JoaoVictorGordo/high-speed-robot/monografia/LaTeX/Tabelas/table.tex

\begin{table}[H]
\centering
\caption{Tabela Verdade}
\label{IA}
\begin{tabular}{|ccccc|c|}
\hline
 \textbf{Sensor 0} & \textbf{Sensor 1} & \textbf{Sensor 2} & 
 \textbf{Sensor 3} & \textbf{Sensor 4} & \textbf{Ação} \\ 
\hline
 0 & 0 & 0 & 0 & 0 & $FS$ \\ \hline
 0 & 0 & 0 & 0 & 1 & $E_L$ \\ \hline
 0 & 0 & 0 & 1 & 0 & $E_M$ \\ \hline
 0 & 0 & 0 & 1 & 1 & $E_M$ \\ \hline
 0 & 0 & 1 & 0 & 0 & $E_F$ \\ \hline
 0 & 0 & 1 & 0 & 1 & $E_F$ \\ \hline
 0 & 0 & 1 & 1 & 0 & $E_F$ \\ \hline
 0 & 0 & 1 & 1 & 1 & $E_F$ \\ \hline
 0 & 1 & 0 & 0 & 0 & $D_M$ \\ \hline
 0 & 1 & 0 & 0 & 1 & $D_M$ \\ \hline
 0 & 1 & 0 & 1 & 0 & $E_F$ \\ \hline
 0 & 1 & 0 & 1 & 1 & $E_M$ \\ \hline
 0 & 1 & 1 & 0 & 0 & $D_F$ \\ \hline
 0 & 1 & 1 & 0 & 1 & $E_F$ \\ \hline
 0 & 1 & 1 & 1 & 0 & $E_F$ \\ \hline
 0 & 1 & 1 & 1 & 1 & $E_F$ \\ \hline
 1 & 0 & 0 & 0 & 0 & $D_L$ \\ \hline
 1 & 0 & 0 & 0 & 1 & $Fre$ \\ \hline
 1 & 0 & 0 & 1 & 0 & $E_M$ \\ \hline
 1 & 0 & 0 & 1 & 1 & $E_M$ \\ \hline
 1 & 0 & 1 & 0 & 0 & $D_F$ \\ \hline
 1 & 0 & 1 & 0 & 1 & $E_F$ \\ \hline
 1 & 0 & 1 & 1 & 0 & $E_F$ \\ \hline
 1 & 0 & 1 & 1 & 1 & $E_F$ \\ \hline
 1 & 1 & 0 & 0 & 0 & $D_M$ \\ \hline
 1 & 1 & 0 & 0 & 1 & $D_M$ \\ \hline
 1 & 1 & 0 & 1 & 0 & $D_M$ \\ \hline
 1 & 1 & 0 & 1 & 1 & $Fre$ \\ \hline
 1 & 1 & 1 & 0 & 0 & $D_F$ \\ \hline
 1 & 1 & 1 & 0 & 1 & $D_F$ \\ \hline
 1 & 1 & 1 & 1 & 0 & $D_F$ \\ \hline
 1 & 1 & 1 & 1 & 1 & $E_F$ \\ \hline
\end{tabular} 
\end{table}
