JoaoVictorGordo/high-speed-robot/monografia/LaTeX/Tabelas/vazio.tex

% Please add the following required packages to your document preamble:
% \usepackage{multirow}
\begin{table}[H]
\centering
\caption{Teste sem Obstáculos ao Alcance}
\label{vazio}
\begin{tabular}{|c|c|c|ccccc|}\hline
Dados & Contagem & Intervalo & Sensor 0 & Sensor 1 & Sensor 2 & Sensor 3 & Sensor 4 \\ \hline
\multirow{6}{*}{crus} & \multirow{3}{*}{$\neq 400$} & 30ms & 0\% & 1,22\% & 0\% & 1,48\% & 0\% \\
 &  & 45ms & 0,67\% & 0,92\% & 0\% & 1,58\% & 0\% \\
 &  & 60ms & 3,17\% & 0,58\% & 0\% & 2,67\% & 0\% \\ \cline{2-8} 
 & \multirow{3}{*}{\textless \hspace{0,5mm} 10} & 30ms & 0\% & 0\% & 0\% & 0,78\% & 0\% \\
 &  & 45ms & 0,67\% & 0\% & 0\% & 0,83\% & 0\% \\
 &  & 60ms & 3,17\% & 0\% & 0\% & 1,08\% & 0\% \\ \hline
\multirow{6}{*}{processados} & \multirow{3}{*}{$\neq 400$} & 30ms & 0\% & 0,70\% & 0\% & 0,35\% & 0\% \\
 &  & 45ms & 0\% & 0,25\% & 0\% & 0,33\% & 0\% \\
 &  & 60ms & 0\% & 0,08\% & 0\% & 1,09\% & 0\% \\ \cline{2-8} 
 & \multirow{3}{*}{\textless \hspace{0,5mm} 10} & 30ms & 0\% & 0\% & 0\% & 0\% & 0\% \\
 &  & 45ms & 0\% & 0\% & 0\% & 0\% & 0\% \\
 &  & 60ms & 0\% & 0\% & 0\% & 0\% & 0\% \\ \hline
\end{tabular}
\end{table}
