JoaoVictorGordo/high-speed-robot/monografia/LaTeX/Template/folhadeaprovacao.tex

% Alternativa para a Folha de Aprovação 
% Se esta for a sua opção, exclua inclusão feita acima do arquivo folhadeaprovacao.pdf
%
\begin{folhadeaprovacao}
  \begin{center}
       {\ABNTEXchapterfont\bfseries\large\imprimirautor}
	 \vspace*{2cm}
   
    \begin{center}
      \ABNTEXchapterfont\bfseries\Large\imprimirtitulo
    \end{center}
		\vspace*{2cm}
		\hspace{.45\textwidth}
    \begin{minipage}{.5\textwidth}
        \imprimirpreambulo
    \end{minipage}
		\vspace*{2cm}
    %\vspace*{\fill}
	\end{center}

  \begin{center}
	  {\ABNTEXchapterfont\bfseries\large\ {Trabalho de Conclus\~ao de Curso defendido e aprovado\\
	  em 22 de junho de 2017}, pela Comiss\~ao Julgadora: \\}
		\par
		\vspace*{2cm}
		{\ABNTEXchapterfont\bfseries\large Prof. Dr.  Eduardo do Valle Sim\~oes - Orientador - SSC/ICMC/USP \\}
		\vspace*{1cm}
		{\ABNTEXchapterfont\bfseries\large Prof. Dr.  Marcelo Bas\'ilio Joaquim - SEL/EESC/USP\\}
		\vspace*{1cm}
		{\ABNTEXchapterfont\bfseries\large Prof. Dr.  Cl\'audio Fabiano Motta Toledo - SSC/ICMC/USP \\}
		\vspace*{1cm}
		%\assinatura{\textbf{Professor} \\ Convidado3}
		%\assinatura{\textbf{Professor} \\ Convidado4}
		%\begin{center}
		\vspace*{\fill}
   	{\ABNTEXchapterfont\bfseries\large Coordenador da CoC-Engenharia El\'etrica - EESC/USP: \\}
   	{\ABNTEXchapterfont\bfseries\large Prof. Associado Jos\'e Carlos de Melo Vieira J\'unior}
    \par
\end{center}
\end{folhadeaprovacao}
% ---
