JoaoVictorGordo/high-speed-robot/monografia/LaTeX/Tabelas/30.tex

% Please add the following required packages to your document preamble:
% \usepackage{multirow}
\begin{center}
\begin{longtable}{|c|c|c|ccccc|}
\label{30cm} \\
\caption[30cm]{30cm} \endfirsthead \\
\caption[]{30cm} \\
\hline \multicolumn{3}{|c|}{{Continua na próxima página.}} \\ \hline
\endfoot \hline
\hline \hline
\endlastfoot
\hline
\textbf{Medida} & \textbf{Intervalo} & \textbf{Leitura} & \textbf{Sensor 0} & \textbf{Sensor 1} & \textbf{Sensor 2} & \textbf{Sensor 3} & \textbf{Sensor 4} \\ \hline
\multirow{12}{*}{\begin{tabular}[c]{@{}c@{}}Média\\ {[}cm{]}\end{tabular}} & \multirow{4}{*}{30ms} & Est. & 26,43 & 30,13 & 31,14 & 35,62 & 37,19 \\
 &  & Din. & 26,58 & 30,57 & 30,55 & 35,67 & 37,51 \\
 &  & Est. & 26,37 & 30,12 & 30,99 & 35,66 & 37,21 \\
 &  & Din. & 26,42 & 30,60 & 32,17 & 35,61 & 37,52 \\ \cline{2-8} 
 & \multirow{4}{*}{45ms} & Est. & 26,36 & 30,51 & 32,61 & 35,67 & 37,34 \\
 &  & Din. & 26,39 & 30,86 & 32,31 & 35,76 & 37,73 \\
 &  & Est. & 26,45 & 30,26 & 31,59 & 35,75 & 37,17 \\
 &  & Din. & 26,42 & 30,29 & 29,11 & 35,65 & 37,36 \\ \cline{2-8} 
 & \multirow{4}{*}{60ms} & Est. & 26,41 & 30,12 & 31,28 & 35,67 & 37,21 \\
 &  & Din. & 26,72 & 30,48 & 31,11 & 35,71 & 37,65 \\
 &  & Est. & 26,46 & 30,01 & 30,38 & 35,61 & 37,15 \\
 &  & Din. & 26,52 & 30,35 & 28,47 & 35,50 & 37,33 \\ \hline
\multirow{12}{*}{\begin{tabular}[c]{@{}c@{}}Média\\ Limpa\\ {[}cm{]}\end{tabular}} & \multirow{4}{*}{30ms} & Est. & 26,43 & 30,13 & 31,14 & 35,62 & 37,19 \\
 &  & Din. & 26,58 & 30,57 & 31,16 & 35,67 & 37,51 \\
 &  & Est. & 26,37 & 30,12 & 30,99 & 35,66 & 37,21 \\
 &  & Din. & 26,42 & 30,60 & 32,69 & 35,61 & 37,52 \\ \cline{2-8} 
 & \multirow{4}{*}{45ms} & Est. & 26,36 & 30,51 & 32,61 & 35,67 & 37,34 \\
 &  & Din. & 26,39 & 30,86 & 32,82 & 35,76 & 37,73 \\
 &  & Est. & 26,45 & 30,26 & 31,59 & 35,75 & 37,17 \\
 &  & Din. & 26,42 & 30,29 & 31,91 & 35,65 & 37,36 \\ \cline{2-8} 
 & \multirow{4}{*}{60ms} & Est. & 26,41 & 30,12 & 31,28 & 35,67 & 37,21 \\
 &  & Din. & 26,72 & 30,48 & 31,59 & 35,71 & 37,65 \\
 &  & Est. & 26,46 & 30,01 & 30,38 & 35,61 & 37,15 \\
 &  & Din. & 26,52 & 30,35 & 30,84 & 35,50 & 37,33 \\ \hline \pagebreak
\multirow{12}{*}{\begin{tabular}[c]{@{}c@{}}Desvio\\ Padrão\\ {[}cm{]}\end{tabular}} & \multirow{4}{*}{30ms} & Est. & 0,50 & 0,34 & 1,51 & 0,49 & 0,41 \\
 &  & Din. & 0,50 & 0,50 & 4,19 & 0,55 & 0,53 \\
 &  & Est. & 0,48 & 0,33 & 1,19 & 0,48 & 0,43 \\
 &  & Din. & 0,50 & 0,49 & 4,35 & 0,59 & 0,55 \\ \cline{2-8} 
 & \multirow{4}{*}{45ms} & Est. & 0,48 & 0,50 & 1,68 & 0,47 & 0,52 \\
 &  & Din. & 0,49 & 0,35 & 4,12 & 0,54 & 0,62 \\
 &  & Est. & 0,50 & 0,44 & 1,63 & 0,44 & 0,41 \\
 &  & Din. & 0,50 & 0,46 & 8,18 & 0,48 & 0,63 \\ \cline{2-8} 
 & \multirow{4}{*}{60ms} & Est. & 0,49 & 0,33 & 1,42 & 0,47 & 0,41 \\
 &  & Din. & 0,45 & 0,50 & 4,10 & 0,50 & 0,69 \\
 &  & Est. & 0,50 & 0,12 & 0,70 & 0,49 & 0,38 \\
 &  & Din. & 0,50 & 0,48 & 7,47 & 0,50 & 0,49 \\ \hline
\multirow{12}{*}{\textless avg - 15} & \multirow{4}{*}{30ms} & Est. & 0,00\% & 0\% & 0\% & 0\% & 0\% \\
 &  & Din. & 0\% & 0\% & 2,67\% & 0\% & 0\% \\
 &  & Est. & 0\% & 0\% & 0\% & 0\% & 0\% \\
 &  & Din. & 0\% & 0\% & 2,00\% & 0\% & 0\% \\ \cline{2-8} 
 & \multirow{4}{*}{45ms} & Est. & 0\% & 0\% & 0\% & 0\% & 0\% \\
 &  & Din. & 0\% & 0\% & 2,00\% & 0\% & 0\% \\
 &  & Est. & 0\% & 0\% & 0\% & 0\% & 0\% \\
 &  & Din. & 0\% & 0\% & 11,33\% & 0\% & 0\% \\ \cline{2-8} 
 & \multirow{4}{*}{60ms} & Est. & 0\% & 0\% & 0\% & 0\% & 0\% \\
 &  & Din. & 0\% & 0\% & 2,00\% & 0\% & 0\% \\
 &  & Est. & 0\% & 0\% & 0\% & 0\% & 0\% \\
 &  & Din. & 0\% & 0\% & 10,00\% & 0\% & 0\% \\ \hline
\multirow{12}{*}{\textgreater avg + 15} & \multirow{4}{*}{30ms} & Est. & 0\% & 0\% & 1,33\% & 0\% & 0\% \\
 &  & Din. & 0\% & 0\% & 4,00\% & 0\% & 0\% \\
 &  & Est. & 0\% & 0\% & 0,67\% & 0\% & 0\% \\
 &  & Din. & 0\% & 0\% & 4,67\% & 0\% & 0\% \\ \cline{2-8} 
 & \multirow{4}{*}{45ms} & Est. & 0\% & 0\% & 0\% & 0\% & 0\% \\
 &  & Din. & 0\% & 0\% & 1,33\% & 0\% & 0\% \\
 &  & Est. & 0\% & 0\% & 0\% & 0\% & 0\% \\
 &  & Din. & 0\% & 0\% & 6,67\% & 0\% & 0\% \\ \cline{2-8} 
 & \multirow{4}{*}{60ms} & Est. & 0\% & 0\% & 0\% & 0\% & 0\% \\
 &  & Din. & 0\% & 0\% & 7,33\% & 0\% & 0\% \\
 &  & Est. & 0\% & 0\% & 0\% & 0\% & 0\% \\
 &  & Din. & 0\% & 0\% & 6,67\% & 0\% & 0\% \\ \hline
\multirow{12}{*}{= 400} & \multirow{4}{*}{30ms} & Est. & 0\% & 0\% & 0\% & 0\% & 0\% \\
 &  & Din. & 0\% & 0\% & 0\% & 0\% & 0\% \\
 &  & Est. & 0\% & 0\% & 0\% & 0\% & 0\% \\
 &  & Din. & 0\% & 0\% & 0\% & 0\% & 0\% \\ \cline{2-8} 
 & \multirow{4}{*}{45ms} & Est. & 0\% & 0\% & 0\% & 0\% & 0\% \\
 &  & Din. & 0\% & 0\% & 0\% & 0\% & 0\% \\
 &  & Est. & 0\% & 0\% & 0\% & 0\% & 0\% \\
 &  & Din. & 0\% & 0\% & 0\% & 0\% & 0\% \\ \cline{2-8} 
 & \multirow{4}{*}{60ms} & Est. & 0\% & 0\% & 0\% & 0\% & 0\% \\
 &  & Din. & 0\% & 0\% & 0\% & 0\% & 0\% \\
 &  & Est. & 0\% & 0\% & 0\% & 0\% & 0\% \\
 &  & Din. & 0\% & 0\% & 0\% & 0\% & 0\% \\ \hline
\end{longtable}
\end{center}
