JoaoVictorGordo/high-speed-robot/monografia/LaTeX/Tabelas/50.tex

% Please add the following required packages to your document preamble:
% \usepackage{multirow}
\begin{center}
\begin{longtable}{|c|c|c|ccccc|}
\label{50cm} \\
\caption[50cm]{50cm} \endfirsthead \\
\caption[]{50cm} \\
\hline \multicolumn{3}{|c|}{{Continua na próxima página.}} \\ \hline
\endfoot \hline
\hline \hline
\endlastfoot
\hline
\textbf{Medida} & \textbf{Intervalo} & \textbf{Leitura} & \textbf{Sensor 0} & \textbf{Sensor 1} & \textbf{Sensor 2} & \textbf{Sensor 3} & \textbf{Sensor 4} \\ \hline
\multirow{12}{*}{\begin{tabular}[c]{@{}c@{}}Média\\ {[}cm{]}\end{tabular}} & \multirow{4}{*}{30ms} & Est. & 44,80 & 47,77 & 50,86 & 48,39 & 53,25 \\
 &  & Din. & 44,57 & 47,87 & 50,13 & 48,59 & 53,65 \\
 &  & Est. & 45,21 & 47,91 & 50,86 & 48,35 & 52,49 \\
 &  & Din. & 44,95 & 47,83 & 50,65 & 48,77 & 52,65 \\ \cline{2-8} 
 & \multirow{4}{*}{45ms} & Est. & 45,35 & 47,46 & 50,45 & 48,53 & 53,61 \\
 &  & Din. & 44,85 & 47,85 & 52,61 & 48,92 & 63,21 \\
 &  & Est. & 44,70 & 47,72 & 51,35 & 48,56 & 53,06 \\
 &  & Din. & 44,79 & 47,91 & 50,87 & 48,67 & 60,42 \\ \cline{2-8} 
 & \multirow{4}{*}{60ms} & Est. & 45,86 & 47,76 & 50,81 & 48,49 & 51,69 \\
 &  & Din. & 45,27 & 47,85 & 50,74 & 48,94 & 52,55 \\
 &  & Est. & 45,68 & 47,89 & 51,54 & 48,61 & 53,26 \\
 &  & Din. & 44,78 & 47,63 & 51,29 & 48,73 & 51,33 \\ \hline  
\multirow{12}{*}{\begin{tabular}[c]{@{}c@{}}Média\\ Limpa\\ {[}cm{]}\end{tabular}} & \multirow{4}{*}{30ms} & Est. & 44,80 & 47,77 & 50,86 & 48,39 & 53,25 \\
 &  & Din. & 44,57 & 47,87 & 50,13 & 48,59 & 53,65 \\
 &  & Est. & 45,21 & 47,91 & 50,86 & 48,35 & 52,49 \\
 &  & Din. & 44,95 & 47,83 & 50,65 & 48,77 & 52,65 \\ \cline{2-8} 
 & \multirow{4}{*}{45ms} & Est. & 45,35 & 47,46 & 50,45 & 48,53 & 53,61 \\
 &  & Din. & 44,85 & 47,85 & 52,61 & 48,92 & 63,21 \\
 &  & Est. & 44,70 & 47,72 & 51,35 & 48,56 & 53,06 \\
 &  & Din. & 44,79 & 47,91 & 50,87 & 48,67 & 60,42 \\ \cline{2-8} 
 & \multirow{4}{*}{60ms} & Est. & 45,86 & 47,76 & 50,81 & 48,49 & 51,69 \\
 &  & Din. & 45,27 & 47,85 & 50,74 & 48,94 & 52,55 \\
 &  & Est. & 45,68 & 47,89 & 51,54 & 48,61 & 53,26 \\
 &  & Din. & 44,78 & 47,63 & 51,29 & 48,73 & 51,33 \\ \hline
\multirow{12}{*}{\begin{tabular}[c]{@{}c@{}}Desvio\\ Padrão\\ {[}cm{]}\end{tabular}} & \multirow{4}{*}{30ms} & Est. & 0,65 & 0,42 & 0,74 & 0,50 & 11,99 \\
 &  & Din. & 0,56 & 0,33 & 1,48 & 0,53 & 12,93 \\
 &  & Est. & 2,96 & 0,29 & 0,74 & 0,48 & 11,24 \\
 &  & Din. & 1,00 & 0,37 & 1,17 & 0,49 & 11,11 \\ \cline{2-8} 
 & \multirow{4}{*}{45ms} & Est. & 3,38 & 0,50 & 0,97 & 0,51 & 13,46 \\
 &  & Din. & 0,63 & 0,36 & 1,16 & 0,54 & 28,66 \\
 &  & Est. & 0,76 & 0,45 & 0,81 & 0,50 & 12,03 \\
 &  & Din. & 0,53 & 0,28 & 0,70 & 0,51 & 26,26 \\ \cline{2-8} 
 & \multirow{4}{*}{60ms} & Est. & 7,40 & 0,43 & 0,87 & 0,50 & 7,44 \\
 &  & Din. & 2,98 & 0,35 & 0,81 & 0,48 & 8,89 \\
 &  & Est. & 6,25 & 0,31 & 0,81 & 0,50 & 11,92 \\
 &  & Din. & 0,53 & 0,48 & 1,30 & 0,49 & 5,41 \\ \hline
\multirow{12}{*}{\textless avg - 15} & \multirow{4}{*}{30ms} & Est. &0\% &0\% &0\% &0\% &0\% \\
 &  & Din. &0\% &0\% &0\% &0\% &0\% \\
 &  & Est. &0\% &0\% &0\% &0\% &0\% \\
 &  & Din. &0\% &0\% &0\% &0\% &0\% \\ \cline{2-8} 
 & \multirow{4}{*}{45ms} & Est. &0\% &0\% &0\% &0\% &0\% \\
 &  & Din. &0\% &0\% &0\% &0\% &0\% \\
 &  & Est. &0\% &0\% &0\% &0\% &0\% \\
 &  & Din. &0\% &0\% &0\% &0\% &0\% \\ \cline{2-8} 
 & \multirow{4}{*}{60ms} & Est. &0\% &0\% &0\% &0\% &0\% \\
 &  & Din. &0\% &0\% &0\% &0\% &0\% \\
 &  & Est. &0\% &0\% &0\% &0\% &0\% \\
 &  & Din. &0\% &0\% &0\% &0\% &0\% \\ \hline
\multirow{12}{*}{\textgreater avg + 15} & \multirow{4}{*}{30ms} & Est. &0\% &0\% &0\% &0\% & 4,00\% \\
 &  & Din. &0\% &0\% &0\% &0\% & 5,33\% \\
 &  & Est. & 0,67\% &0\% &0\% &0\% & 2,67\% \\
 &  & Din. &0\% &0\% &0\% &0\% & 2,67\% \\ \cline{2-8} 
 & \multirow{4}{*}{45ms} & Est. & 0,67\% &0\% &0\% &0\% & 4,00\% \\
 &  & Din. &0\% &0\% &0\% &0\% & 16,00\% \\
 &  & Est. &0\% &0\% &0\% &0\% & 3,33\% \\
 &  & Din. &0\% &0\% &0\% &0\% & 12,67\% \\ \cline{2-8} 
 & \multirow{4}{*}{60ms} & Est. & 1,33\% &0\% &0\% &0\% & 1,33\% \\
 &  & Din. & 0,67\% &0\% &0\% &0\% & 2,67\% \\
 &  & Est. & 1,33\% &0\% &0\% &0\% & 4,67\% \\
 &  & Din. &0\% &0\% &0\% &0\% & 0,67\% \\ \hline
\multirow{12}{*}{= 400} & \multirow{4}{*}{30ms} & Est. &0\% &0\% &0\% &0\% &0\% \\
 &  & Din. &0\% &0\% &0\% &0\% &0\% \\
 &  & Est. &0\% &0\% &0\% &0\% &0\% \\
 &  & Din. &0\% &0\% &0\% &0\% &0\% \\ \cline{2-8} 
 & \multirow{4}{*}{45ms} & Est. &0\% &0\% &0\% &0\% &0\% \\
 &  & Din. &0\% &0\% &0\% &0\% &0\% \\
 &  & Est. &0\% &0\% &0\% &0\% &0\% \\
 &  & Din. &0\% &0\% &0\% &0\% &0\% \\ \cline{2-8} 
 & \multirow{4}{*}{60ms} & Est. &0\% &0\% &0\% &0\% &0\% \\
 &  & Din. &0\% &0\% &0\% &0\% &0\% \\
 &  & Est. &0\% &0\% &0\% &0\% &0\% \\
 &  & Din. &0\% &0\% &0\% &0\% &0\% \\ \hline
\end{longtable}
\end{center}
