JoaoVictorGordo/high-speed-robot/monografia/LaTeX/Tabelas/interf-motor-sonar_1.tex

% Please add the following required packages to your document preamble:
% \usepackage{multirow}
\begin{table}[]
\centering
\caption{Teste 1}
\label{teste_1}
\begin{tabular}{|c|c|ccccc|}
\hline
\textbf{Motores}                & \textbf{Medida}  & \textbf{Sensor 0} & \textbf{Sensor 1} & \textbf{Sensor 2} & \textbf{Sensor 3} & \textbf{Sensor 4} \\ \hline
\multirow{3}{*}{STP}            & Média            & 399               & 339               & 400               & 400               & 400               \\
                                & \textless 400    & 0,43\%            & 21,26\%           & 0\%            & 0\%            & 0\%            \\
                                & \textgreater 400 & 0\%            & 0\%            & 0\%            & 0\%            & 0\%            \\ \hline
\multirow{3}{*}{E\_L}           & Média            & 399               & 236               & 400               & 400               & 400               \\
                                & \textless 400    & 0,30\%            & 59,34\%           & 0\%            & 0\%            & 0\%            \\
                                & \textgreater 400 & 0\%            & 0\%            & 0\%            & 0\%            & 0\%            \\ \hline
\multirow{3}{*}{E\_M}           & Média            & 400               & 219               & 400               & 400               & 400               \\
                                & \textless 400    & 0\%            & 66,56\%           & 0\%            & 0\%            & 0\%            \\
                                & \textgreater 400 & 0\%            & 0\%            & 0\%            & 0\%            & 0\%            \\ \hline
\multirow{3}{*}{E\_F}           & Média            & 400               & 233               & 400               & 400               & 400               \\
                                & \textless 400    & 0\%            & 61,28\%           & 0\%            & 0\%            & 0\%            \\
                                & \textgreater 400 & 0\%            & 0\%            & 0\%            & 0\%            & 0\%            \\ \hline
\multirow{3}{*}{D\_L}           & Média            & 399               & 316               & 400               & 400               & 400               \\
                                & \textless 400    & 0,34\%            & 31,54\%           & 0\%            & 0\%            & 0\%            \\
                                & \textgreater 400 & 0\%            & 0\%            & 0\%            & 0\%            & 0\%            \\ \hline
\multirow{3}{*}{D\_M}           & Média            & 400               & 217               & 400               & 400               & 400               \\
                                & \textless 400    & 0\%            & 66,78\%           & 0\%            & 0\%            & 0\%            \\
                                & \textgreater 400 & 0\%            & 0\%            & 0\%            & 0\%            & 0\%            \\ \hline
\multirow{3}{*}{D\_F}           & Média            & 400               & 247               & 400               & 400               & 400               \\
                                & \textless 400    & 0\%            & 55,56\%           & 0\%            & 0\%            & 0\%            \\
                                & \textgreater 400 & 0\%            & 0\%            & 0\%            & 0\%            & 0\%            \\ \hline
\multirow{3}{*}{FS}             & Média            & 400               & 290               & 400               & 400               & 400               \\
                                & \textless 400    & 0\%            & 40,27\%           & 0\%            & 0\%            & 0\%            \\
                                & \textgreater 400 & 0\%            & 0\%            & 0\%            & 0\%            & 0\%            \\ \hline
\multirow{3}{*}{Fre}            & Média            & 400               & 156               & 400               & 400               & 400               \\
                                & \textless 400    & 0\%            & 89,23\%           & 0\%            & 0\%            & 0\%            \\
                                & \textgreater 400 & 0\%            & 0\%            & 0\%            & 0\%            & 0\%            \\ \hline
\multirow{4}{*}{\textbf{TOTAL}} & Média            & 399               & 261               & 400               & 400               & 400               \\
                                & Desvio Padrão    & 13                & 138               & 0                 & 0                 & 0                 \\
                                & \textless 400    & 0,16\%            & 50,42\%           & 0\%            & 0\%            & 0\%            \\
                                & \textgreater 400 & 0\%            & 0\%            & 0\%            & 0\%            & 0\%            \\ \hline
\end{tabular}
\end{table}
