JoaoVictorGordo/high-speed-robot/monografia/LaTeX/Tabelas/interf-motor-sonar_2.tex

% Please add the following required packages to your document preamble:
% \usepackage{multirow}
\begin{table}[H]
\centering
\caption{Teste com os Sonares Apoiados no Chão}
\label{teste_2}
\begin{tabular}{|c|c|ccccc|}
\hline
\textbf{Motores}                & \textbf{Medida}  & \textbf{Sensor 0} & \textbf{Sensor 1} & \textbf{Sensor 2} & \textbf{Sensor 3} & \textbf{Sensor 4} \\ \hline
\multirow{3}{*}{STP}            & Média            & 400               & 373               & 400               & 400               & 400               \\
                                & \textless 400    & 0\%            & 11,09\%           & 0\%            & 0\%            & 0\%            \\
                                & \textgreater 400 & 0\%            & 0\%            & 0\%            & 0\%            & 0\%            \\ \hline
\multirow{3}{*}{E\_L}           & Média            & 400               & 141               & 400               & 400               & 400               \\
                                & \textless 400    & 0\%            & 89,55\%           & 0\%            & 0\%            & 0\%            \\
                                & \textgreater 400 & 0\%            & 0\%            & 0\%            & 0\%            & 0\%            \\ \hline
\multirow{3}{*}{E\_M}           & Média            & 400               & 121               & 400               & 400               & 400               \\
                                & \textless 400    & 0\%            & 96,97\%           & 0\%            & 0\%            & 0\%            \\
                                & \textgreater 400 & 0\%            & 0\%            & 0\%            & 0\%            & 0\%            \\ \hline
\multirow{3}{*}{E\_F}           & Média            & 400               & 116               & 400               & 400               & 400               \\
                                & \textless 400    & 0\%            & 98,48\%           & 0\%            & 0\%            & 0\%            \\
                                & \textgreater 400 & 0\%            & 0\%            & 0\%            & 0\%            & 0\%            \\ \hline
\multirow{3}{*}{D\_L}           & Média            & 400               & 207               & 400               & 400               & 400               \\
                                & \textless 400    & 0\%            & 67,84\%           & 0\%            & 0\%            & 0\%            \\
                                & \textgreater 400 & 0\%            & 0\%            & 0\%            & 0\%            & 0\%            \\ \hline
\multirow{3}{*}{D\_M}           & Média            & 400               & 148               & 400               & 400               & 400               \\
                                & \textless 400    & 0\%            & 87,94\%           & 0\%            & 0\%            & 0\%            \\
                                & \textgreater 400 & 0\%            & 0\%            & 0\%            & 0\%            & 0\%            \\ \hline
\multirow{3}{*}{D\_F}           & Média            & 400               & 242               & 400               & 400               & 400               \\
                                & \textless 400    & 0\%            & 56,57\%           & 0\%            & 0\%            & 0\%            \\
                                & \textgreater 400 & 0\%            & 0\%            & 0\%            & 0\%            & 0\%            \\ \hline
\multirow{3}{*}{FS}             & Média            & 400               & 218               & 400               & 400               & 400               \\
                                & \textless 400    & 0\%            & 64,65\%           & 0\%            & 0\%            & 0\%            \\
                                & \textgreater 400 & 0\%            & 0\%            & 0\%            & 0\%            & 0\%            \\ \hline
\multirow{3}{*}{Fre}            & Média            & 400               & 123               & 400               & 400               & 400               \\
                                & \textless 400    & 0\%            & 96,48\%           & 0\%            & 0\%            & 0\%            \\
                                & \textgreater 400 & 0\%            & 0\%            & 0\%            & 0\%            & 0\%            \\ \hline
\multirow{4}{*}{\textbf{TOTAL}} & Média            & 400               & 210               & 400               & 400               & 400               \\
                                & Desvio Padrão    & 0                 & 135               & 0                 & 0                 & 0                 \\
                                & \textless 400    & 0\%            & 66,83\%           & 0\%            & 0\%            & 0\%            \\
                                & \textgreater 400 & 0\%            & 0\%            & 0\%            & 0\%            & 0\%            \\ \hline
\end{tabular}
\end{table}
