JoaoVictorGordo/high-speed-robot/monografia/LaTeX/Tabelas/interf-motor-sonar_4.tex

% Please add the following required packages to your document preamble:
% \usepackage{multirow}
\begin{table}[H]
\centering
\caption{Teste com os Sonares Acoplados ao Veículo}
\label{teste_4}
\begin{tabular}{|c|c|ccccc|}
\hline
\textbf{Motores}                & \textbf{Medida}  & \textbf{Sensor 0} & \textbf{Sensor 1} & \textbf{Sensor 2} & \textbf{Sensor 3} & \textbf{Sensor 4} \\ \hline
\multirow{3}{*}{STP}            & Média            & 400               & 400               & 400               & 398               & 400               \\
                                & \textless 400    & 0,23\%            & 0\%            & 0\%            & 0,70\%            & 0\%            \\
                                & \textgreater 400 & 0\%            & 0\%            & 0\%            & 0\%            & 0\%            \\ \hline
\multirow{3}{*}{E\_L}           & Média            & 163               & 222               & 400               & 90                & 232               \\
                                & \textless 400    & 91,58\%           & 66,34\%           & 0\%            & 98,51\%           & 71,29\%           \\
                                & \textgreater 400 & 3,47\%            & 0\%            & 0\%            & 0\%            & 4,46\%            \\ \hline
\multirow{3}{*}{E\_M}           & Média            & 143               & 196               & 400               & 90                & 209               \\
                                & \textless 400    & 98,48\%           & 77,78\%           & 0\%            & 100\%          & 83,33\%           \\
                                & \textgreater 400 & 1,01\%            & 0\%            & 0\%            & 0\%            & 4,55\%            \\ \hline
\multirow{3}{*}{E\_F}           & Média            & 176               & 198               & 400               & 91                & 250               \\
                                & \textless 400    & 93,43\%           & 77,27\%           & 0\%            & 100\%          & 61,62\%           \\
                                & \textgreater 400 & 2,02\%            & 0\%            & 0\%            & 0\%            & 2,53\%            \\ \hline
\multirow{3}{*}{D\_L}           & Média            & 174               & 229               & 400               & 84                & 238               \\
                                & \textless 400    & 89,95\%           & 62,81\%           & 0\%            & 100\%          & 66,33\%           \\
                                & \textgreater 400 & 2,51\%            & 0\%            & 0\%            & 0\%            & 4,02\%            \\ \hline
\multirow{3}{*}{D\_M}           & Média            & 180               & 332               & 400               & 99                & 369               \\
                                & \textless 400    & 94,95\%           & 27,27\%           & 0\%            & 100\%          & 21,21\%           \\
                                & \textgreater 400 & 1,52\%            & 0\%            & 0\%            & 0\%            & 3,03\%            \\ \hline
\multirow{3}{*}{D\_F}           & Média            & 292               & 386               & 400               & 132               & 380               \\
                                & \textless 400    & 50,25\%           & 6,03\%            & 0\%            & 99,50\%           & 14,57\%           \\
                                & \textgreater 400 & 5,53\%            & 0\%            & 0\%            & 0,50\%            & 2,01\%            \\ \hline
\multirow{3}{*}{FS}             & Média            & 192               & 232               & 400               & 90                & 253               \\
                                & \textless 400    & 77,89\%           & 60,80\%           & 0\%            & 99,50\%           & 57,29\%           \\
                                & \textgreater 400 & 0,50\%            & 0\%            & 0\%            & 0,50\%            & 0,50\%            \\ \hline
\multirow{3}{*}{Fre}            & Média            & 181               & 252               & 400               & 86                & 274               \\
                                & \textless 400    & 81,82\%           & 53,03\%           & 0\%            & 100\%          & 56,06\%           \\
                                & \textgreater 400 & 2,02\%            & 0\%            & 0\%            & 0\%            & 2,53\%            \\ \hline
\multirow{4}{*}{\textbf{TOTAL}} & Média            & 233               & 287               & 400               & 160               & 302               \\
                                & Desvio Padrão    & 132               & 134               & 0                 & 128               & 128               \\
                                & \textless 400    & 66,80\%           & 42,45\%           & 0\%            & 78,62\%           & 42,50\%           \\
                                & \textgreater 400 & 1,83\%            & 0\%            & 0\%            & 0,10\%            & 2,33\%            \\ \hline
\end{tabular}
\end{table}
