JoaoVictorGordo/high-speed-robot/monografia/LaTeX/Tabelas/interf-motor-sonar_5.tex

% Please add the following required packages to your document preamble:
% \usepackage{multirow}
\begin{table}[]
\centering
\caption{Teste 5}
\label{teste_5}
\begin{tabular}{|c|c|ccccc|}
\hline
\textbf{Motores}                & \textbf{Medida}  & \textbf{Sensor 0} & \textbf{Sensor 1} & \textbf{Sensor 2} & \textbf{Sensor 3} & \textbf{Sensor 4} \\ \hline
\multirow{3}{*}{STP}            & Média            & 399               & 399               & 400               & 398               & 399               \\
                                & \textless 400    & 0,37\%            & 0,37\%            & 0\%            & 0,75\%            & 0,37\%            \\
                                & \textgreater 400 & 0\%            & 0\%            & 0\%            & 0\%            & 0\%            \\ \hline
\multirow{3}{*}{E\_L}           & Média            & 205               & 276               & 400               & 154               & 383               \\
                                & \textless 400    & 84,85\%           & 45,96\%           & 0\%            & 95,45\%           & 10,10\%           \\
                                & \textgreater 400 & 8,08\%            & 0\%            & 0\%            & 2,53\%            & 3,54\%            \\ \hline
\multirow{3}{*}{E\_M}           & Média            & 148               & 326               & 400               & 220               & 331               \\
                                & \textless 400    & 99,49\%           & 27,78\%           & 0\%            & 73,23\%           & 32,32\%           \\
                                & \textgreater 400 & 0,51\%            & 0\%            & 0\%            & 1,52\%            & 3,54\%            \\ \hline
\multirow{3}{*}{E\_F}           & Média            & 204               & 363               & 400               & 247               & 365               \\
                                & \textless 400    & 83,33\%           & 14,65\%           & 0\%            & 56,06\%           & 21,21\%           \\
                                & \textgreater 400 & 3,54\%            & 0\%            & 0\%            & 3,03\%            & 4,04\%            \\ \hline
\multirow{3}{*}{D\_L}           & Média            & 203               & 293               & 400               & 179               & 367               \\
                                & \textless 400    & 83,42\%           & 41,21\%           & 0\%            & 81,41\%           & 14,57\%           \\
                                & \textgreater 400 & 5,03\%            & 0\%            & 0\%            & 2,51\%            & 0,50\%            \\ \hline
\multirow{3}{*}{D\_M}           & Média            & 210               & 397               & 400               & 285               & 400               \\
                                & \textless 400    & 88,24\%           & 0,98\%            & 0\%            & 63,73\%           & 0\%            \\
                                & \textgreater 400 & 2,94\%            & 0\%            & 0\%            & 6,86\%            & 0\%            \\ \hline
\multirow{3}{*}{D\_F}           & Média            & 316               & 400               & 400               & 400               & 400               \\
                                & \textless 400    & 47,47\%           & 0\%            & 0\%            & 0\%            & 0\%            \\
                                & \textgreater 400 & 6,06\%            & 0\%            & 0\%            & 0\%            & 0\%            \\ \hline
\multirow{3}{*}{FS}             & Média            & 247               & 325               & 400               & 211               & 355               \\
                                & \textless 400    & 63,64\%           & 30,30\%           & 0\%            & 73,74\%           & 17,17\%           \\
                                & \textgreater 400 & 2,02\%            & 0\%            & 0\%            & 4,04\%            & 0\%            \\ \hline
\multirow{3}{*}{Fre}            & Média            & 200               & 306               & 400               & 186               & 395               \\
                                & \textless 400    & 83,84\%           & 33,33\%           & 0\%            & 84,85\%           & 2,02\%            \\
                                & \textgreater 400 & 4,04\%            & 1,01\%            & 0\%            & 6,06\%            & 2,02\%            \\ \hline
\multirow{4}{*}{\textbf{TOTAL}} & Média            & 243               & 342               & 400               & 255               & 376               \\
                                & Desvio Padrão    & 128               & 111               & 0                 & 139               & 75                \\
                                & \textless 400    & 67,17\%           & 22,07\%           & 0\%            & 56,96\%           & 11,99\%           \\
                                & \textgreater 400 & 3,36\%            & 0,07\%            & 0\%            & 2,47\%            & 1,71\%            \\ \hline
\end{tabular}
\end{table}
