JoaoVictorGordo/high-speed-robot/monografia/LaTeX/Template/USPSC-Dedicatoria.tex

%% USPSC-Dedicatória.tex
% ---
% Dedicatória
% ---
\begin{dedicatoria}
   \vspace*{\fill}
   \centering
   \noindent
   \textit{ Este trabalho é dedicado aos alunos da USP, como uma contribuição\\
  das Bibliotecas do Campus USP de São Carlos para o desenvolvimento\\
	e disseminação da pesquisa científica da Universidade.} \vspace*{\fill}
\end{dedicatoria}
% ---
