JoaoVictorGordo/high-speed-robot/monografia/LaTeX/Template/USPSC-modelo-seg.tex

%% USPSC-modelo.tex
% ---------------------------------------------------------------
% USPSC: Modelo de Trabalho Academico (tese de doutorado, dissertacao de
% mestrado e trabalhos monograficos em geral) em conformidade com 
% ABNT NBR 14724:2011: Informacao e documentacao - Trabalhos academicos -
% Apresentacao
%----------------------------------------------------------------
%% Esta é uma customização do abntex2-modelo-trabalho-academico.tex de v-1.9.5 laurocesar 
%% para as Unidades do Campus USP de São Carlos:
%% EESC - Escola de Engenharia de São Carlos
%% IAU - Instituto de Arquitetura e Urbanismo
%% ICMC - Instituto de Ciências Matemáticas e de Computação
%% IFSC - Instituto de Física de São Carlos
%% IQSC - Instituto de Química de São Carlos
%%
%% Este trabalho utiliza a classe USPSC.cls que é mantida pela seguinte equipe:
%% 
%% Programação:
%%   - Marilza Aparecida Rodrigues Tognetti - marilza@sc.usp.br (PUSP-SC)
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

% Complementarmente, verifique as instruções abaixo sobre os Pacotes de Nota de rodapé
% ---
% Pacotes de Nota de rodapé
% Configurações de nota de rodapé

% O presente modelo adota o formato numérico para as notas de rodapés quando utiliza o sistema de chamada autor-data para citações e referências. Para utilizar o sistema de chamada numérico para citações e referências, habilitar um dos comandos abaixo.
% Há diversa opções para nota de rodapé no Sistema Numérico.  Para o IFSC, habilitade o comando abaixo.

%\renewcommand{\thefootnote}{\fnsymbol{footnote}}  %Comando para inserção de símbolos em nota de rodapé

% Outras opções para nota de rodapé no Sistema Numérico:
%\renewcommand{\thefootnote}{\alph{footnote}}      %Comando para inserção de letras minúscula em nota de rodapé
%\renewcommand{\thefootnote}{\Alph{footnote}}      %Comando para inserção de letras maiúscula em nota de rodapé
%\renewcommand{\thefootnote}{\roman{footnote}}     %Comando para inserção de números romanos minúsculos  em nota de rodapé
%\renewcommand{\thefootnote}{\Roman{footnote}}     %Comando para inserção de números romanos minúsculos  em nota de rodapé

\renewcommand{\footnotesize}{\small} %Comando para diminuir a fonte das notas de rodapé

 % ---
 % Pacote para agrupar a citação numérica consecutiva
 % Quando for adotado o Sistema Numérico, a exemplo do IFSC, habilite 
 % o pacote cite abaixo retirando a porcentagem antes do comando abaixo
 %\usepackage[superscript]{cite}	

% ---
% Pacotes adicionais, usados apenas no âmbito do Modelo Canônico do abnteX2
% ---
\usepackage{lipsum}				% para geração de dummy text
% ---

% pacotes de tabelas
\usepackage{multicol}	% Suporte a mesclagens em colunas
\usepackage{multirow}	% Suporte a mesclagens em linhas
\usepackage{longtable}	% Tabelas com várias páginas
\usepackage{threeparttablex}    % notas no longtable
\usepackage{array}

%---
% Configurações para o pacote chemfig
%\chemsetup[chemformula]{format=\sffamily}
\renewcommand*\printatom[1]{\ensuremath{\mathsf{#1}}}
\setatomsep{2em}
\setdoublesep{.6ex}
\setbondstyle{semithick}
%---
% Configurando o ambiente para utilizar os recursos de frases pre-prontas do mhchem
\newenvironment{rslist}%
{%
	\begin{labeling}% environment from KOMA-script
		{\rsnumber{R39/23/24/25}}% R39/23/24/25 is longest label
	}{%
\end{labeling}%
}%
% Definição de comando para utilizar os recursos de frases pre-prontas do mhchem
\newcommand{\rs}[2][]{\item[{\rsnumber[#1]{#2}}] \rsphrase{bb}}
% ---

% ---
% DADOS INICIAIS - Define sigla com título, área de concentração e opção do Programa 
% Consulte a tabela referente aos Programas, áreas e opções de sua unidade contante do
% arquivo USPSC-Siglas estabelecidas para os Programas de Pós-Graduação por Unidade.xlsx 
% ou nos APÊNDICES A-E
\siglaunidade{EESC}
\programa{DCEA}
% Os demais dados deverão ser fornecidos no arquivo USPSC-pre-textual-UUUU, onde UUUU é a sigla da Unidade. 
% Exemplo:USPSC-pre-textual-IFSC.tex
% ---
% Configurações de aparência do PDF final
% alterando o aspecto da cor azul
\definecolor{blue}{RGB}{41,5,195}

% informações do PDF
\makeatletter
\hypersetup{
	%pagebackref=true,
	pdftitle={\@title}, 
	pdfauthor={\@author},
	pdfsubject={\imprimirpreambulo},
	pdfcreator={LaTeX with abnTeX2},
	pdfkeywords={abnt}{latex}{abntex}{USPSC}{trabalho acadêmico}, 
	colorlinks=true,       		% false: boxed links; true: colored links
	linkcolor=blue,          	% color of internal links
	citecolor=blue,        		% color of links to bibliography
	filecolor=magenta,      		% color of file links
	urlcolor=blue,
	bookmarksdepth=4
}
\makeatother
% --- 
% --- 
% Espaçamentos entre linhas e parágrafos 
% --- 

% O tamanho do parágrafo é dado por:
\setlength{\parindent}{1.3cm}

% Controle do espaçamento entre um parágrafo e outro:
\setlength{\parskip}{0.2cm}  % tente também \onelineskip

% ---
% compila o sumário e índice
\makeindex
% ---

% ----
% Início do documento
% ----
\begin{document}

% Seleciona o idioma do documento (conforme pacotes do babel)
\selectlanguage{brazil}
% Se o idioma do texto for inglês, inclua uma % antes do 
%      comando \selectlanguage{brazil} e 
%      retire a % antes do comando abaixo
%\selectlanguage{english}

% Retira espaço extra obsoleto entre as frases.
\frenchspacing 

% --- Formatação dos Títulos
\renewcommand{\ABNTEXchapterfontsize}{\fontsize{12}{12}\bfseries}
\renewcommand{\ABNTEXsectionfontsize}{\fontsize{12}{12}\bfseries}
\renewcommand{\ABNTEXsubsectionfontsize}{\fontsize{12}{12}\normalfont}
\renewcommand{\ABNTEXsubsubsectionfontsize}{\fontsize{12}{12}\normalfont}
\renewcommand{\ABNTEXsubsubsubsectionfontsize}{\fontsize{12}{12}\normalfont}

% ----------------------------------------------------------
% ELEMENTOS PRÉ-TEXTUAIS
% ----------------------------------------------------------
% ---
% Capa
% ---
\imprimircapa
% ---
% Folha de rosto
% (o * indica impressão em anverso (frente) e verso )
% ---
\imprimirfolhaderosto*
%\imprimirfolhaderosto
% ---

% ---
% Inserir a ficha catalográfica em pdf
% ---
% A biblioteca da sua Unidade lhe fornecerá um PDF com a ficha
% catalográfica definitiva. 
% Quando estiver com o documento, salve-o como PDF no diretório
% do seu projeto como fichacatalografica.pdf e iclua o arquivo
% utilizando o comando abaixo:
\begin{fichacatalografica}
   \includepdf{fichacatalografica.pdf}
\end{fichacatalografica}
% Se você optar por elaborar a ficha catalográfica, deverá 
% incluir uma % antes das 3 linhas acima e tirar a % antes
% do comando \include{USPSC-fichacatalografica}
%\include{USPSC-fichacatalografica}
% As informações que compõem a ficha catalográfica estão 
% definidos no arquivo USPSC-pre-textual-UUUU.tex
% ---

% ---
% Inserir errata
% ---

\begin{errata}
	\OnehalfSpacing 			
	A errata é um elemento opcional, que consiste de uma lista de erros da obra, precedidos pelas folhas e linhas onde eles ocorrem e seguidos pelas correções correspondentes. Deve ser inserida logo após a folha de rosto e conter a referência do trabalho para facilitar sua identificação, conforme a ABNT NBR 14724 \cite{nbr14724}.
	
	Modelo de Errata:
		
	\begin{flushleft} 
			\setlength{\absparsep}{0pt} % ajusta o espaçamento da referência	
			\SingleSpacing 
			\imprimirautorabr~ ~\textbf{\imprimirtitulo}.	\imprimirdata. \pageref{LastPage}p. 
			%Substitua p. por f. quando utilizar oneside em \documentclass
			%\pageref{LastPage}f.
			\imprimirtipotrabalho~-~\imprimirinstituicao, \imprimirlocal, \imprimirdata. 
 	\end{flushleft}
\vspace{\onelineskip}
\OnehalfSpacing 
\center
\textbf{ERRATA}
\vspace{\onelineskip}
\OnehalfSpacing 
\begin{table}[htb]
	\center
	\footnotesize
	\begin{tabular}{p{1.4cm} p{1cm} p{3cm} p{3cm} }
		\hline
		\textbf{Folha} & \textbf{Linha}  & \textbf{Onde se lê}  & \textbf{Leia-se}  \\
			\hline
			1 & 10 & auto-conclavo & autoconclavo\\
		\hline
	\end{tabular}
\end{table}

\end{errata}
% ---

% ---
% Inserir folha de aprovação
% ---

% A Folha de aprovação é um elemento obrigatório da NBR 4724/2011 (seção 4.2.1.3). 
% Após a defesa/aprovação do trabalho, gere o arquivo folhadeaprovacao.pdf da página assinada pela banca 
% e iclua o arquivo utilizando o comando abaixo:
\includepdf{folhadeaprovacao.pdf}

% Alternativa para a Folha de Aprovação:
% Se for a sua opção elaborar uma folha de aprovação, insira uma % antes do comando acima que inclui o arquivo folhadeaprovacao.pdf,
% tire o % do comando abaixo e altere o arquivo folhadeaprovacao.tex conforme suas necessidades
%\include{folhadeaprovacao}

\includepdf{PaginaEmBranco.pdf}

% ---
% Dedicatória
% ---
\begin{dedicatoria}
   \vspace*{\fill}
   \centering
   \noindent
   \textit{ Este trabalho é dedicado aos alunos da USP, como uma contribuição\\
  das Bibliotecas do Campus USP de São Carlos para o desenvolvimento\\
	e disseminação da pesquisa científica da Universidade.} \vspace*{\fill}
\end{dedicatoria}
% ---

% ---
% Agradecimentos
% ---=====
\begin{agradecimentos}
A motivação para o desenvolvimento da classe USPSC e dos modelos de dissertações e teses foi decorrente de solicitações de usuários das Bibliotecas do Campus USP de São Carlos. 

O Grupo desenvolvedor do Pacote USPSC, atualmente composto da Classe USPSC e do  Modelo para teses e dissertações em \LaTeX\ utilizando a classe USPSC, agradece especialmente ao Luis Olmes, doutorando do Instituto de Ciências Matemáticas e de Computação (ICMC) da Universidade de São Paulo (USP), pelas primeiras orientações sobre o \LaTeX\ .

Agradecemos ao Lauro César Araujo pelo desenvolvimento da classe  \abnTeX, modelos canônicos e tantas outras contribuições que nos permitiu o desenvolvimento da classe USPSC e seus modelos.

Os nossos agradecimentos aos integrantes do primeiro
projeto abn\TeX\, Gerald Weber, Miguel Frasson, Leslie H. Watter, Bruno Parente Lima, Flávio de Vasconcellos Corrêa, Otavio Real
Salvador, Renato Machnievscz, e a todos que contribuíram para que a produção de trabalhos acadêmicos em conformidade com
as normas ABNT com \LaTeX\ fosse possível.

Agradecemos ao grupo de usuários
\emph{latex-br}{\url{http://groups.google.com/group/latex-br}}, aos integrantes do grupo
\emph{\abnTeX}{\url{http://groups.google.com/group/abntex2}  e \url{http://www.abntex.net.br/}}~que contribuem para a evolução do \abnTeX.
\end{agradecimentos}
% ---

% ---
% Epígrafe
% ---
\begin{epigrafe}
    \vspace*{\fill}
	\begin{flushright}
		\textit{``O estudo, a busca da verdade e da beleza são domínios \\
		em que nos é consentido sermos crianças por toda a vida.''\\
		Albert Einstein}
	\end{flushright}
\end{epigrafe}
% ---

% ---
% Resumo
% ---
% Se o idioma do texto for em inglês, o abstract deve preceder o resumo
% resumo em português
\setlength{\absparsep}{18pt} % ajusta o espaçamento dos parágrafos do resumo		
\begin{resumo}
	\begin{flushleft} 
			\setlength{\absparsep}{0pt} % ajusta o espaçamento da referência	
			\SingleSpacing 
			\imprimirautorabr~ ~\textbf{\imprimirtitulo}.	\imprimirdata. \pageref{LastPage}p. 
			%Substitua p. por f. quando utilizar oneside em \documentclass
			%\pageref{LastPage}f.
			\imprimirtipotrabalho~-~\imprimirinstituicao, \imprimirlocal, \imprimirdata. 
 	\end{flushleft}
\OnehalfSpacing 			
 O resumo deve ressaltar o  objetivo, o método, os resultados e as conclusões do documento. A ordem e a extensão  destes itens dependem do tipo de resumo (informativo ou indicativo) e do  tratamento que cada item recebe no documento original. O resumo deve ser
 precedido da referência do documento, com exceção do resumo inserido no
 próprio documento. (\ldots)  Salientamos que os Programas de Pós-Graduação de algumas Unidades exigem o titulo da dissertação ou tese em inglês, tornando necessário a inclusão das referências nos resumos e abstracts, o que foi adotado no presente modelo. As palavras-chave devem figurar logo abaixo do  resumo, antecedidas da expressão Palavras-chave:, separadas entre si por  ponto e finalizadas também por ponto \cite{nbr6028}.

 \textbf{Palavras-chave}: LaTeX. abnTeX. Classe USPSC. Editoração de texto. Normalização da documentação. Tese. Dissertação. Documentos (elaboração). Documentos eletrônicos. 
\end{resumo}

% ---
% Abstract
% ---
\autor{Silva, M. J.}
\begin{resumo}[Abstract]
 \begin{otherlanguage*}{english}
	\begin{flushleft} 
		\setlength{\absparsep}{0pt} % ajusta o espaçamento dos parágrafos do resumo		
 		\SingleSpacing 
 		\imprimirautorabr~ ~\textbf{\imprimirtitleabstract}.	\imprimirdata.  \pageref{LastPage}p. 
		%Substitua p. por f. quando utilizar oneside em \documentclass
		%\pageref{LastPage}f.
		\imprimirtipotrabalho~-~\imprimirinstituicao, \imprimirlocal, 	\imprimirdata. 
 	\end{flushleft}
	\OnehalfSpacing 
   This is the english abstract.

   \vspace{\onelineskip}
 
   \noindent 
   \textbf{Keywords}: LaTeX. abnTeX. USPSC class. Text editoration. Standardization of documentation. Thesis. Dissertation. Documents (development). Electronic documents.
 \end{otherlanguage*}
\end{resumo}

% ---
% inserir lista de ilustrações
% ---
\pdfbookmark[0]{\listfigurename}{lof}
\listoffigures*
\cleardoublepage
% ---

% ---
% inserir lista de tabelas
% ---
\pdfbookmark[0]{\listtablename}{lot}
\listoftables*
\cleardoublepage
% ---

% ---
% inserir lista de quadros
% ---
\pdfbookmark[0]{\listofquadroname}{loq}
\listofquadro*
\cleardoublepage
% ---

% ---
% inserir lista de abreviaturas e siglas
% ---
\begin{siglas}
    \item[ABNT] Associação Brasileira de Normas Técnicas
    \item[abnTeX] ABsurdas Normas para TeX
	\item[EESC] Escola de Engenharia de São Carlos
	\item[IAU] Instituto de Arquitetura e Urbanismo
	\item[IBGE] Instituto Brasileiro de Geografia e Estatística
	\item[ICMC] Instituto de Ciências Matemáticas e de Computação
	\item[IFSC] Instituto de Física de São Carlos
	\item[IQSC] Instituto de Química de São Carlos
	\item[USP] Universidade de São Paulo
	\item[USPSC] Campus USP de São Carlos
	
\end{siglas}
% ---

% ---
% inserir lista de símbolos
% ---
\begin{simbolos}
  \item[$ \Gamma $] Letra grega Gama
  \item[$ \Lambda $] Lambda
  \item[$ \zeta $] Letra grega minúscula zeta
  \item[$ \in $] Pertence
\end{simbolos}
% ---
% ---
% inserir o sumario
% ---
\pdfbookmark[0]{\contentsname}{toc}
\tableofcontents*
\cleardoublepage
% ---
% ----------------------------------------------------------
% ELEMENTOS TEXTUAIS
% ----------------------------------------------------------
\textual
% Os capítulos são inseridos como arquivos externos 

% Capítulo 1 - Introdução
% ---
\include{USPSC-Cap1-Introducao}
% ---

% ---
% Capítulo 2
% ---
\include{USPSC-Cap2-Desenvolvimento}
% ---
% Capítulo 3 - Citações
% ---
\include{USPSC-Cap3-Citacoes}

% ---
% Capítulo 4 - Referencias
% ---
\include{USPSC-Cap4-Referencias}
% ---

% Capítulo 5 - Conclusão
% ---
\include{USPSC-Cap5-Conclusao}
% ---

% ----------------------------------------------------------
% ELEMENTOS PÓS-TEXTUAIS
% ----------------------------------------------------------
\postextual
% ----------------------------------------------------------

% -----------------------------------------------------------
% Referências bibliográficas
% ----------------------------------------------------------
\bibliography{USPSC-modelo-references}

% ----------------------------------------------------------
% Glossário
% ----------------------------------------------------------
%
% Consulte o manual da classe abntex2 para orientações sobre o glossário.
%
%\glossary

% ----------------------------------------------------------
% Apêndices
% ----------------------------------------------------------
\include{USPSC-Apendices}

% ----------------------------------------------------------
% Anexos
% ----------------------------------------------------------
\include{USPSC-Anexos}

%---------------------------------------------------------------------
% INDICE REMISSIVO
%--------------------------------------------------------------------
\phantompart
\printindex

%---------------------------------------------------------------------

\end{document}
