JoaoVictorGordo/high-speed-robot/monografia/LaTeX/Template/USPSC-TCC-modelo.tex

% %% USPSC-TCC-modelo.tex
% ---------------------------------------------------------------
% USPSC: Modelo de Trabalho Academico (tese de doutorado, dissertacao de
% mestrado e trabalhos monograficos em geral) em conformidade com 
% ABNT NBR 14724:2011: Informacao e documentacao - Trabalhos academicos -
% Apresentacao
%----------------------------------------------------------------
%% Esta é uma customização do abntex2-modelo-trabalho-academico.tex de v-1.9.5 laurocesar 
%% para as Unidades do Campus USP de São Carlos:
%% EESC - Escola de Engenharia de São Carlos
%% IAU - Instituto de Arquitetura e Urbanismo
%% ICMC - Instituto de Ciências Matemáticas e de Computação
%% IFSC - Instituto de Física de São Carlos
%% IQSC - Instituto de Química de São Carlos
%%
%% Este trabalho utiliza a classe USPSC.cls que é mantida pela seguinte equipe:
%% 
%% Programação:
%%   - Marilza Aparecida Rodrigues Tognetti - marilza@sc.usp.br (PUSP-SC)
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

% Complementarmente, verifique as instruções abaixo sobre os Pacotes de Nota de rodapé
% ---
% Pacotes de Nota de rodapé
% Configurações de nota de rodapé

% O presente modelo adota o formato numérico para as notas de rodapés quando utiliza o sistema de chamada autor-data para citações e referências. Para utilizar o sistema de chamada numérico para citações e referências, habilitar um dos comandos abaixo.
% Há diversa opções para nota de rodapé no Sistema Numérico.  Para o IFSC, habilitade o comando abaixo.

%\renewcommand{\thefootnote}{\fnsymbol{footnote}}  %Comando para inserção de símbolos em nota de rodapé

% Outras opções para nota de rodapé no Sistema Numérico:
%\renewcommand{\thefootnote}{\alph{footnote}}      %Comando para inserção de letras minúscula em nota de rodapé
%\renewcommand{\thefootnote}{\Alph{footnote}}      %Comando para inserção de letras maiúscula em nota de rodapé
%\renewcommand{\thefootnote}{\roman{footnote}}     %Comando para inserção de números romanos minúsculos  em nota de rodapé
%\renewcommand{\thefootnote}{\Roman{footnote}}     %Comando para inserção de números romanos minúsculos  em nota de rodapé

\renewcommand{\footnotesize}{\small} %Comando para diminuir a fonte das notas de rodapé

 % ---
 % Pacote para agrupar a citação numérica consecutiva
 % Quando for adotado o Sistema Numérico, a exemplo do IFSC, habilite 
 % o pacote cite abaixo retirando a porcentagem antes do comando abaixo

% pacotes de tabelas
\usepackage{multicol}	% Suporte a mesclagens em colunas
\usepackage{multirow}	% Suporte a mesclagens em linhas
\usepackage{longtable}	% Tabelas com várias páginas
\usepackage{threeparttablex}    % notas no longtable
\usepackage{array}

%---
% Configurações para o pacote chemfig
%\chemsetup[chemformula]{format=\sffamily}
\renewcommand*\printatom[1]{\ensuremath{\mathsf{#1}}}
\setatomsep{2em}
\setdoublesep{.6ex}
\setbondstyle{semithick}
%---
% Configurando o ambiente para utilizar os recursos de frases pre-prontas do mhchem
\newenvironment{rslist}%
{%
	\begin{labeling}% environment from KOMA-script
		{\rsnumber{R39/23/24/25}}% R39/23/24/25 is longest label
	}{%
\end{labeling}%
}%
% Definição de comando para utilizar os recursos de frases pre-prontas do mhchem
\newcommand{\rs}[2][]{\item[{\rsnumber[#1]{#2}}] \rsphrase{bb}}
% ---

% ---
% DADOS INICIAIS - Define sigla com título, área de concentração e opção do Programa 
% Consulte a tabela referente aos Cursos de Graduação de sua unidade contante do
% arquivo USPSC-TCC-Siglas estabelecidas para as Graduações por Unidade.xlsx 
% ou no APÊNDICES G
\siglaunidade{EESC-TCC} 
\programa{EELT}
% Os demais dados deverão ser fornecidos no arquivo USPSC-pre-textual-UUUU ou USPSC-TCC-pre-textual-UUUU, onde UUUU é a sigla da Unidade. 
% Exemplo:USPSC-pre-textual-IFSC.tex
% ---
% Configurações de aparência do PDF final
% alterando o aspecto da cor azul
\definecolor{blue}{RGB}{41,5,195}

% informações do PDF
\makeatletter
\hypersetup{
	%pagebackref=true,
	pdftitle={\@title}, 
	pdfauthor={\@author},
	pdfsubject={\imprimirpreambulo},
	pdfcreator={LaTeX with abnTeX2},
	pdfkeywords={navegação autônoma}{sistemas reativos}{sensores ultrassônicos}{desvio de obstáculos}, 
	colorlinks=true,       		% false: boxed links; true: colored links
	linkcolor=blue,          	% color of internal links
	citecolor=blue,        		% color of links to bibliography
	filecolor=magenta,      		% color of file links
	urlcolor=blue,
	bookmarksdepth=4
}
\makeatother
% --- 
% --- 
% Espaçamentos entre linhas e parágrafos 
% --- 

% O tamanho do parágrafo é dado por:
\setlength{\parindent}{1.3cm}

% Controle do espaçamento entre um parágrafo e outro:
\setlength{\parskip}{0.2cm}  % tente também \onelineskip

% ---
% compila o sumário e índice
\makeindex
% ---

% ----
% Início do documento
% ----
\begin{document}

% Seleciona o idioma do documento (conforme pacotes do babel)
\selectlanguage{brazil}
% Se o idioma do texto for inglês, inclua uma % antes do 
%      comando \selectlanguage{brazil} e 
%      retire a % antes do comando abaixo
%\selectlanguage{english}

% Retira espaço extra obsoleto entre as frases.
\frenchspacing 

% --- Formatação dos Títulos
\renewcommand{\ABNTEXchapterfontsize}{\fontsize{12}{12}\bfseries}
\renewcommand{\ABNTEXsectionfontsize}{\fontsize{12}{12}\bfseries}
\renewcommand{\ABNTEXsubsectionfontsize}{\fontsize{12}{12}\normalfont}
\renewcommand{\ABNTEXsubsubsectionfontsize}{\fontsize{12}{12}\normalfont}
\renewcommand{\ABNTEXsubsubsubsectionfontsize}{\fontsize{12}{12}\normalfont}

% ----------------------------------------------------------
% ELEMENTOS PRÉ-TEXTUAIS
% ----------------------------------------------------------
% ---
% Capa
% ---
\imprimircapa
% ---
% Folha de rosto
% (o * indica impressão em anverso (frente) e verso )
% ---
\imprimirfolhaderosto*

\includepdf{fichacatalografica.pdf}

%\imprimirfolhaderosto
% ---
% ---
% Inserir a ficha catalográfica em pdf
% ---
% A biblioteca da sua Unidade lhe fornecerá um PDF com a ficha
% catalográfica definitiva. 
% Quando estiver com o documento, salve-o como PDF no diretório
% do seu projeto como fichacatalografica.pdf e iclua o arquivo
% utilizando o comando abaixo:
%\includepdf{USPSC-Tese-pre-textual/fichacatalografica.pdf} 
% Se você optar por elaborar a ficha catalográfica, deverá 
% incluir uma % antes da linha % antes
% do comando \include{USPSC-Tese-pre-textual/USPSC-fichacatalografica} 
% e retirar o % do comando abaixo
%\include{USPSC-Tese-pre-textual/USPSC-fichacatalografica}
% As informações que compõem a ficha catalográfica estão 
% definidos no arquivo USPSC-pre-textual-UUUU.tex
% ---

% ---
% ---
% Inserir errata
% ---

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

% ---
% Inserir folha de aprovação
% ---

% A Folha de aprovação é um elemento obrigatório da NBR 4724/2011 (seção 4.2.1.3). 
% Após a defesa/aprovação do trabalho, gere o arquivo folhadeaprovacao.pdf da página assinada pela banca 
% e iclua o arquivo utilizando o comando abaixo:

 \includepdf{folhadeaprovacao.pdf}
 
% Alternativa para a Folha de Aprovação:
% Se for a sua opção elaborar uma folha de aprovação, insira uma % antes do comando acima que inclui o arquivo folhadeaprovacao.pdf,
% tire o % do comando abaixo e altere o arquivo folhadeaprovacao.tex conforme suas necessidades
% \include{folhadeaprovacao}

% \include{USPSC-fichacatalografica}
\includepdf{PaginaEmBranco.pdf}

% ---
% Agradecimentos
% ---
\begin{agradecimentos}
Eu gostaria de agradecer à comunidade que vive o paradigma revolucionário de disseminação livre e gratuita de ideias e trabalhos.
Este projeto é um fruto tímido de uma árvore regada pelos esforços de cada uma destas pessoas que, de gota em gota, clareiam as águas 
turvadas pelo egoísmo e nutrem a germinação de verdadeiros pomares que estão por vir. Quem sabe um dia o único obstáculo ao aprendizado e construção 
do conhecimento seja a força de vontade...
\end{agradecimentos}
% ---

% Resumo
% ---
\input{../Resumo/Resumo.tex}
% ---

% ---
% inserir lista de figurass
% ---
\pdfbookmark[0]{\listfigurename}{lof}
\listoffigures*
\cleardoublepage
% ---

% ---
% inserir lista de tabelas
% ---
\pdfbookmark[0]{\listtablename}{lot}
\listoftables*
\cleardoublepage
% ---

% ---
% inserir lista de quadros
% ---
% \pdfbookmark[0]{\listofquadroname}{loq}
% \listofquadro*
% \cleardoublepage
% ---

% ---
% inserir lista de abreviaturas e siglas
% ---
\begin{siglas}
  \item[CC] Corrente Contínua
  \item[PWM] \textit{Pulse Width Modulation}
  \item[ESC] \textit{Electronic Speed Controller}
  \item[IDE] \textit{Integrated Development Environment}
  \item[ISM] \textit{Industrial, Scientific and Medical}
  \item[UHF] \textit{Ultra High Frequency}
  \item[SPI] \textit{Serial Peripheral Interface} 
  \item[USB] \textit{Universal Serial Bus}
  \item[CRC] \textit{Cyclic Redundancy Check}
  \item[GFSK] \textit{Gaussian Frequency Shift Keying}
  \item[BLDC] \textit{Brushless Direct Current}
  \item[FIFO] \textit{First In First Out}
  \item[VANT] \textit{Veículo Aereo Não Tripulado}
  \item[UBEC] \textit{Ultimate Batterie Eliminator Circuit}
  \item[LiPo] Lítio Polímero
  \item[MIFA] \textit{Meandered Inverted-F Antenna}
  \item[ICSP] \textit{In-Circuit Serial Programming}
\end{siglas}

% ---

% ---
% inserir lista de símbolos
% ---
\begin{simbolos}
  \item[$ \alpha $] coeficiente de atenuação do meio.
  \item[$ \tau $] tempo de meia volta da onda propagante, i.e. \textit{time of flight}, do sensor.
  \item[$ \Delta $] distância medida nos sensores do tipo \textit{time of flight}.
  \item[$ \nu $] velocidade de propagação no meio da onda ou partícula nos sensores do tipo \textit{time of flight}.
\end{simbolos}
% ---
% ---
% inserir o sumario
% ---
\pdfbookmark[0]{\contentsname}{toc}
\tableofcontents*
\cleardoublepage
% ---
% ----------------------------------------------------------
% ELEMENTOS TEXTUAIS
% ----------------------------------------------------------
\textual
% Os capítulos são inseridos como arquivos externos 
\input{../Introducao/Introducao.tex}
\input{../EmbasamentoTeorico/EmbasamentoTeorico.tex}
\input{../Materiais/Materiais.tex}
\input{../Metodos/Metodos.tex}
\input{../Resultados/Resultados.tex}
\input{../Conclusao/Conclusao.tex}

% ----------------------------------------------------------
% ELEMENTOS PÓS-TEXTUAIS
% ----------------------------------------------------------
\postextual
% ----------------------------------------------------------

% -----------------------------------------------------------
% Referências bibliográficas
% ----------------------------------------------------------
\bibliography{../Bibliografia/Bibliografia.bib}

% ----------------------------------------------------------
% Glossário
% ----------------------------------------------------------
%
% Consulte o manual da classe abntex2 para orientações sobre o glossário.
%
%\glossary

% ----------------------------------------------------------
% Apêndices
% ----------------------------------------------------------
\input{../Apendices/Apendices.tex}

%---------------------------------------------------------------------
% INDICE REMISSIVO
%--------------------------------------------------------------------
\include{USPSC-IndicesRemissivos}

%---------------------------------------------------------------------

\end{document}
