JoaoVictorGordo/high-speed-robot/monografia/LaTeX/Tabelas/bkp2/100.tex

% Please add the following required packages to your document preamble:
% \usepackage{multirow}
\begin{center}
\begin{longtable}{|c|c|c|ccccc|}
\label{100cm} \\
\caption[100cm]{100cm} \endfirsthead \\
\caption[]{100cm} \\
\hline \multicolumn{3}{|c|}{{Continua na próxima página.}} \\ \hline
\endfoot \hline
\hline \hline
\endlastfoot
\hline
\textbf{Medida} & \textbf{Intervalo} & \textbf{Leitura} & \textbf{Sensor 0} & \textbf{Sensor 1} & \textbf{Sensor 2} & \textbf{Sensor 3} & \textbf{Sensor 4} \\ \hline
\multirow{12}{*}{\begin{tabular}[c]{@{}c@{}}Média\\ {[}cm{]}\end{tabular}} & \multirow{4}{*}{30ms} & Est. & 102,49 & 106,83 & 96,83 & 92,05 & 94,19 \\
 &  & Din. & 102,71 & 107,05 & 97,07 & 92,46 & 94,74 \\
 &  & Est. & 102,41 & 106,85 & 96,83 & 92,21 & 94,49 \\
 &  & Din. & 102,46 & 106,91 & 97,19 & 92,54 & 94,54 \\ \cline{2-8} 
 & \multirow{4}{*}{45ms} & Est. & 102,78 & 106,86 & 96,96 & 92,05 & 94,29 \\
 &  & Din. & 102,31 & 106,82 & 97,10 & 92,37 & 94,49 \\
 &  & Est. & 102,41 & 106,89 & 97,07 & 92,20 & 94,27 \\
 &  & Din. & 102,37 & 106,83 & 97,07 & 92,23 & 94,20 \\ \cline{2-8} 
 & \multirow{4}{*}{60ms} & Est. & 102,63 & 106,96 & 97,46 & 92,14 & 94,24 \\
 &  & Din. & 102,34 & 106,81 & 97,23 & 92,46 & 94,53 \\
 &  & Est. & 102,59 & 106,90 & 97,07 & 92,43 & 94,60 \\
 &  & Din. & 102,07 & 106,77 & 97,18 & 92,51 & 94,65 \\ \hline
\multirow{12}{*}{\begin{tabular}[c]{@{}c@{}}Média\\ Limpa\\ {[}cm{]}\end{tabular}} & \multirow{4}{*}{30ms} & Est. & 102,49 & 106,83 & 96,83 & 92,05 & 94,19 \\
 &  & Din. & 102,71 & 107,05 & 97,07 & 92,46 & 94,74 \\
 &  & Est. & 102,41 & 106,85 & 96,83 & 92,21 & 94,49 \\
 &  & Din. & 102,46 & 106,91 & 97,19 & 92,54 & 94,54 \\ \cline{2-8} 
 & \multirow{4}{*}{45ms} & Est. & 102,78 & 106,86 & 96,96 & 92,05 & 94,29 \\
 &  & Din. & 102,31 & 106,82 & 97,10 & 92,37 & 94,49 \\
 &  & Est. & 102,41 & 106,89 & 97,07 & 92,20 & 94,27 \\
 &  & Din. & 102,37 & 106,83 & 97,07 & 92,23 & 94,20 \\ \cline{2-8} 
 & \multirow{4}{*}{60ms} & Est. & 102,63 & 106,96 & 97,46 & 92,14 & 94,24 \\
 &  & Din. & 102,34 & 106,81 & 97,23 & 92,46 & 94,53 \\
 &  & Est. & 102,59 & 106,90 & 97,07 & 92,43 & 94,60 \\
 &  & Din. & 102,07 & 106,77 & 97,18 & 92,51 & 94,65 \\ \hline
\multirow{12}{*}{\begin{tabular}[c]{@{}c@{}}Desvio\\ Padrão\\ {[}cm{]}\end{tabular}} & \multirow{4}{*}{30ms} & Est. & 0,66 & 0,39 & 0,78 & 0,24 & 1,02 \\
 &  & Din. & 0,99 & 0,44 & 0,73 & 0,53 & 1,12 \\
 &  & Est. & 0,66 & 0,38 & 0,77 & 0,41 & 1,01 \\
 &  & Din. & 0,66 & 0,29 & 0,75 & 0,57 & 0,98 \\ \cline{2-8} 
 & \multirow{4}{*}{45ms} & Est. & 0,83 & 0,35 & 0,72 & 0,33 & 1,01 \\
 &  & Din. & 0,60 & 0,39 & 0,78 & 0,56 & 0,99 \\
 &  & Est. & 0,66 & 0,31 & 0,77 & 0,42 & 0,83 \\
 &  & Din. & 0,66 & 0,40 & 0,81 & 0,44 & 0,62 \\ \cline{2-8}  \pagebreak
 & \multirow{4}{*}{60ms} & Est. & 0,69 & 0,33 & 2,52 & 0,37 & 1,07 \\
 &  & Din. & 0,61 & 0,39 & 0,76 & 0,54 & 0,95 \\
 &  & Est. & 0,73 & 0,34 & 0,72 & 0,50 & 1,22 \\
 &  & Din. & 0,53 & 0,42 & 0,71 & 0,58 & 0,99 \\ \hline
\multirow{12}{*}{\textless avg - 15} & \multirow{4}{*}{30ms} & Est. & 0,00\% & 0,00\% & 0,00\% & 0,00\% & 0,00\% \\
 &  & Din. & 0,00\% & 0,00\% & 0,00\% & 0,00\% & 0,00\% \\
 &  & Est. & 0,00\% & 0,00\% & 0,00\% & 0,00\% & 0,00\% \\
 &  & Din. & 0,00\% & 0,00\% & 0,00\% & 0,00\% & 0,00\% \\ \cline{2-8} 
 & \multirow{4}{*}{45ms} & Est. & 0,00\% & 0,00\% & 0,00\% & 0,00\% & 0,00\% \\
 &  & Din. & 0,00\% & 0,00\% & 0,00\% & 0,00\% & 0,00\% \\
 &  & Est. & 0,00\% & 0,00\% & 0,00\% & 0,00\% & 0,00\% \\
 &  & Din. & 0,00\% & 0,00\% & 0,00\% & 0,00\% & 0,00\% \\ \cline{2-8} 
 & \multirow{4}{*}{60ms} & Est. & 0,00\% & 0,00\% & 0,00\% & 0,00\% & 0,00\% \\
 &  & Din. & 0,00\% & 0,00\% & 0,00\% & 0,00\% & 0,00\% \\
 &  & Est. & 0,00\% & 0,00\% & 0,00\% & 0,00\% & 0,00\% \\
 &  & Din. & 0,00\% & 0,00\% & 0,00\% & 0,00\% & 0,00\% \\ \hline
\multirow{12}{*}{\textgreater avg + 15} & \multirow{4}{*}{30ms} & Est. & 0,00\% & 0,00\% & 0,00\% & 0,00\% & 0,00\% \\
 &  & Din. & 0,00\% & 0,00\% & 0,00\% & 0,00\% & 0,00\% \\
 &  & Est. & 0,00\% & 0,00\% & 0,00\% & 0,00\% & 0,00\% \\
 &  & Din. & 0,00\% & 0,00\% & 0,00\% & 0,00\% & 0,00\% \\ \cline{2-8} 
 & \multirow{4}{*}{45ms} & Est. & 0,00\% & 0,00\% & 0,00\% & 0,00\% & 0,00\% \\
 &  & Din. & 0,00\% & 0,00\% & 0,00\% & 0,00\% & 0,00\% \\
 &  & Est. & 0,00\% & 0,00\% & 0,00\% & 0,00\% & 0,00\% \\
 &  & Din. & 0,00\% & 0,00\% & 0,00\% & 0,00\% & 0,00\% \\ \cline{2-8} 
 & \multirow{4}{*}{60ms} & Est. & 0,00\% & 0,00\% & 0,67\% & 0,00\% & 0,00\% \\
 &  & Din. & 0,00\% & 0,00\% & 0,00\% & 0,00\% & 0,00\% \\
 &  & Est. & 0,00\% & 0,00\% & 0,00\% & 0,00\% & 0,00\% \\
 &  & Din. & 0,00\% & 0,00\% & 0,00\% & 0,00\% & 0,00\% \\ \hline
\multirow{12}{*}{= 400} & \multirow{4}{*}{30ms} & Est. & 0,00\% & 0,00\% & 0,00\% & 0,00\% & 0,00\% \\
 &  & Din. & 0,00\% & 0,00\% & 0,00\% & 0,00\% & 0,00\% \\
 &  & Est. & 0,00\% & 0,00\% & 0,00\% & 0,00\% & 0,00\% \\
 &  & Din. & 0,00\% & 0,00\% & 0,00\% & 0,00\% & 0,00\% \\ \cline{2-8} 
 & \multirow{4}{*}{45ms} & Est. & 0,00\% & 0,00\% & 0,00\% & 0,00\% & 0,00\% \\
 &  & Din. & 0,00\% & 0,00\% & 0,00\% & 0,00\% & 0,00\% \\
 &  & Est. & 0,00\% & 0,00\% & 0,00\% & 0,00\% & 0,00\% \\
 &  & Din. & 0,00\% & 0,00\% & 0,00\% & 0,00\% & 0,00\% \\ \cline{2-8} 
 & \multirow{4}{*}{60ms} & Est. & 0,00\% & 0,00\% & 0,00\% & 0,00\% & 0,00\% \\
 &  & Din. & 0,00\% & 0,00\% & 0,00\% & 0,00\% & 0,00\% \\
 &  & Est. & 0,00\% & 0,00\% & 0,00\% & 0,00\% & 0,00\% \\
 &  & Din. & 0,00\% & 0,00\% & 0,00\% & 0,00\% & 0,00\% \\ \hline
\end{longtable}
\end{center}
