JoaoVictorGordo/high-speed-robot/monografia/LaTeX/Tabelas/bkp2/150.tex

% Please add the following required packages to your document preamble:
% \usepackage{multirow}
\begin{center}
\begin{longtable}{|c|c|c|ccccc|}
\label{150cm} \\
\caption[150cm]{150cm} \endfirsthead \\
\caption[]{150cm} \\
\hline \multicolumn{3}{|c|}{{Continua na próxima página.}} \\ \hline
\endfoot \hline
\hline \hline
\endlastfoot
\hline
\textbf{Medida} & \textbf{Intervalo} & \textbf{Leitura} & \textbf{Sensor 0} & \textbf{Sensor 1} & \textbf{Sensor 2} & \textbf{Sensor 3} & \textbf{Sensor 4} \\ \hline
\multirow{12}{*}{\begin{tabular}[c]{@{}c@{}}Média\\ {[}cm{]}\end{tabular}} & \multirow{4}{*}{30ms} & Est. & 148,52 & 152,17 & 152,97 & 156,65 & 230,77 \\
 &  & Din. & 148,70 & 153,18 & 153,45 & 156,41 & 174,46 \\
 &  & Est. & 148,97 & 153,53 & 153,65 & 156,53 & 196,81 \\
 &  & Din. & 149,05 & 153,01 & 153,63 & 156,95 & 176,01 \\ \cline{2-8} 
 & \multirow{4}{*}{45ms} & Est. & 149,13 & 153,13 & 153,95 & 156,42 & 184,03 \\
 &  & Din. & 148,62 & 153,01 & 153,10 & 156,97 & 226,32 \\
 &  & Est. & 148,63 & 151,45 & 153,23 & 157,11 & 210,04 \\
 &  & Din. & 148,90 & 153,04 & 154,24 & 157,13 & 192,36 \\ \cline{2-8} 
 & \multirow{4}{*}{60ms} & Est. & 148,84 & 153,09 & 153,42 & 156,79 & 256,77 \\
 &  & Din. & 148,53 & 152,96 & 153,33 & 157,28 & 161,61 \\
 &  & Est. & 148,49 & 152,95 & 153,03 & 156,81 & 164,53 \\
 &  & Din. & 148,45 & 152,57 & 152,18 & 156,33 & 229,58 \\ \hline \multirow{12}{*}{\begin{tabular}[c]{@{}c@{}}Média\\ Limpa\\ {[}cm{]}\end{tabular}} & \multirow{4}{*}{30ms} & Est. & 148,52 & 152,17 & 152,97 & 156,65 & 158,25 \\
 &  & Din. & 148,70 & 153,18 & 153,45 & 156,41 & 158,35 \\
 &  & Est. & 148,97 & 153,53 & 153,65 & 156,53 & 158,10 \\
 &  & Din. & 149,05 & 153,01 & 153,63 & 156,95 & 158,28 \\ \cline{2-8} 
 & \multirow{4}{*}{45ms} & Est. & 149,13 & 153,13 & 153,95 & 156,42 & 158,25 \\
 &  & Din. & 148,62 & 153,01 & 153,10 & 156,97 & 158,78 \\
 &  & Est. & 148,63 & 151,45 & 153,23 & 157,11 & 158,53 \\
 &  & Din. & 148,90 & 153,04 & 154,24 & 157,13 & 158,56 \\ \cline{2-8} 
 & \multirow{4}{*}{60ms} & Est. & 148,84 & 153,09 & 153,42 & 156,79 & 158,60 \\
 &  & Din. & 148,53 & 152,96 & 153,33 & 157,28 & 158,39 \\
 &  & Est. & 148,49 & 152,95 & 153,03 & 156,81 & 158,08 \\
 &  & Din. & 148,45 & 152,57 & 152,18 & 156,33 & 158,84 \\ \hline \pagebreak
\multirow{12}{*}{\begin{tabular}[c]{@{}c@{}}Desvio\\ Padrão\\ {[}cm{]}\end{tabular}} & \multirow{4}{*}{30ms} & Est. & 0,60 & 7,48 & 6,44 & 0,76 & 111,16 \\
 &  & Din. & 0,63 & 0,39 & 0,64 & 0,88 & 60,49 \\
 &  & Est. & 0,52 & 0,50 & 0,65 & 0,68 & 88,98 \\
 &  & Din. & 0,47 & 0,08 & 0,61 & 0,68 & 63,23 \\ \cline{2-8} 
 & \multirow{4}{*}{45ms} & Est. & 0,42 & 0,33 & 0,73 & 0,74 & 74,88 \\
 &  & Din. & 0,63 & 0,23 & 0,86 & 0,82 & 108,67 \\
 &  & Est. & 0,61 & 9,46 & 0,89 & 0,64 & 99,26 \\
 &  & Din. & 0,47 & 0,30 & 6,01 & 0,72 & 84,06 \\ \cline{2-8} 
 & \multirow{4}{*}{60ms} & Est. & 0,57 & 0,28 & 0,63 & 0,57 & 118,98 \\
 &  & Din. & 0,62 & 0,20 & 0,62 & 0,65 & 27,81 \\
 &  & Est. & 0,54 & 0,21 & 0,68 & 0,61 & 39,11 \\
 &  & Din. & 0,59 & 4,90 & 5,68 & 0,89 & 110,18 \\ \hline
\multirow{12}{*}{\textless avg - 15} & \multirow{4}{*}{30ms} & Est. & 0,00\% & 1,33\% & 0,67\% & 0,00\% & 0,00\% \\
 &  & Din. & 0,00\% & 0,00\% & 0,00\% & 0,00\% & 0,00\% \\
 &  & Est. & 0,00\% & 0,00\% & 0,00\% & 0,00\% & 0,00\% \\
 &  & Din. & 0,00\% & 0,00\% & 0,00\% & 0,00\% & 0,00\% \\ \cline{2-8} 
 & \multirow{4}{*}{45ms} & Est. & 0,00\% & 0,00\% & 0,00\% & 0,00\% & 0,00\% \\
 &  & Din. & 0,00\% & 0,00\% & 0,00\% & 0,00\% & 0,00\% \\
 &  & Est. & 0,00\% & 2,67\% & 0,00\% & 0,00\% & 0,00\% \\
 &  & Din. & 0,00\% & 0,00\% & 0,00\% & 0,00\% & 0,00\% \\ \cline{2-8} 
 & \multirow{4}{*}{60ms} & Est. & 0,00\% & 0,00\% & 0,00\% & 0,00\% & 0,00\% \\
 &  & Din. & 0,00\% & 0,00\% & 0,00\% & 0,00\% & 0,00\% \\
 &  & Est. & 0,00\% & 0,00\% & 0,00\% & 0,00\% & 0,00\% \\
 &  & Din. & 0,00\% & 0,67\% & 1,33\% & 0,00\% & 0,00\% \\ \hline
\multirow{12}{*}{\textgreater avg + 15} & \multirow{4}{*}{30ms} & Est. & 0,00\% & 0,00\% & 0,00\% & 0,00\% & 0,00\% \\
 &  & Din. & 0,00\% & 0,00\% & 0,00\% & 0,00\% & 0,00\% \\
 &  & Est. & 0,00\% & 0,00\% & 0,00\% & 0,00\% & 0,00\% \\
 &  & Din. & 0,00\% & 0,00\% & 0,00\% & 0,00\% & 0,00\% \\ \cline{2-8} 
 & \multirow{4}{*}{45ms} & Est. & 0,00\% & 0,00\% & 0,00\% & 0,00\% & 0,00\% \\
 &  & Din. & 0,00\% & 0,00\% & 0,00\% & 0,00\% & 0,00\% \\
 &  & Est. & 0,00\% & 0,00\% & 0,00\% & 0,00\% & 0,00\% \\
 &  & Din. & 0,00\% & 0,00\% & 0,67\% & 0,00\% & 0,00\% \\ \cline{2-8} 
 & \multirow{4}{*}{60ms} & Est. & 0,00\% & 0,00\% & 0,00\% & 0,00\% & 0,00\% \\
 &  & Din. & 0,00\% & 0,00\% & 0,00\% & 0,00\% & 0,00\% \\
 &  & Est. & 0,00\% & 0,00\% & 0,00\% & 0,00\% & 0,00\% \\
 &  & Din. & 0,00\% & 0,00\% & 0,00\% & 0,00\% & 0,00\% \\ \hline
\multirow{12}{*}{= 400} & \multirow{4}{*}{30ms} & Est. & 0,00\% & 0,00\% & 0,00\% & 0,00\% & 30,00\% \\
 &  & Din. & 0,00\% & 0,00\% & 0,00\% & 0,00\% & 6,67\% \\
 &  & Est. & 0,00\% & 0,00\% & 0,00\% & 0,00\% & 16,00\% \\
 &  & Din. & 0,00\% & 0,00\% & 0,00\% & 0,00\% & 7,33\% \\ \cline{2-8} 
 & \multirow{4}{*}{45ms} & Est. & 0,00\% & 0,00\% & 0,00\% & 0,00\% & 10,67\% \\
 &  & Din. & 0,00\% & 0,00\% & 0,00\% & 0,00\% & 28,00\% \\
 &  & Est. & 0,00\% & 0,00\% & 0,00\% & 0,00\% & 21,33\% \\
 &  & Din. & 0,00\% & 0,00\% & 0,00\% & 0,00\% & 14,00\% \\ \cline{2-8} 
 & \multirow{4}{*}{60ms} & Est. & 0,00\% & 0,00\% & 0,00\% & 0,00\% & 40,67\% \\
 &  & Din. & 0,00\% & 0,00\% & 0,00\% & 0,00\% & 1,33\% \\
 &  & Est. & 0,00\% & 0,00\% & 0,00\% & 0,00\% & 2,67\% \\
 &  & Din. & 0,00\% & 0,00\% & 0,00\% & 0,00\% & 29,33\% \\ \hline
\end{longtable}
\end{center}
