JoaoVictorGordo/high-speed-robot/monografia/LaTeX/Tabelas/bkp2/200.tex

% Please add the following required packages to your document preamble:
% \usepackage{multirow}
\begin{center}
\begin{longtable}{|c|c|c|ccccc|}
\label{200cm} \\
\caption[200cm]{200cm} \endfirsthead \\
\caption[]{200cm} \\
\hline \multicolumn{3}{|c|}{{Continua na próxima página.}} \\ \hline
\endfoot \hline
\hline \hline
\endlastfoot
\hline
\textbf{Medida} & \textbf{Intervalo} & \textbf{Leitura} & \textbf{Sensor 0} & \textbf{Sensor 1} & \textbf{Sensor 2} & \textbf{Sensor 3} & \textbf{Sensor 4} \\ \hline
\multirow{12}{*}{\begin{tabular}[c]{@{}c@{}}Média\\ {[}cm{]}\end{tabular}} & \multirow{4}{*}{30ms} & Est. & 197,58 & 189,40 & 192,26 & 182,45 & 182,72 \\
 &  & Din. & 209,51 & 189,56 & 213,76 & 182,13 & 182,67 \\
 &  & Est. & 216,61 & 189,42 & 206,54 & 182,01 & 182,48 \\
 &  & Din. & 191,33 & 189,25 & 202,63 & 182,43 & 182,72 \\ \cline{2-8} 
 & \multirow{4}{*}{45ms} & Est. & 196,53 & 189,63 & 220,25 & 182,33 & 182,75 \\
 &  & Din. & 239,21 & 189,51 & 208,81 & 182,87 & 183,20 \\
 &  & Est. & 201,98 & 189,55 & 209,55 & 182,76 & 183,12 \\
 &  & Din. & 242,49 & 188,22 & 192,27 & 182,97 & 183,50 \\ \cline{2-8} 
 & \multirow{4}{*}{60ms} & Est. & 199,45 & 189,49 & 189,49 & 182,46 & 186,07 \\
 &  & Din. & 197,21 & 189,61 & 212,97 & 182,71 & 183,24 \\
 &  & Est. & 237,66 & 189,77 & 196,97 & 182,60 & 182,85 \\
 &  & Din. & 198,16 & 188,77 & 192,45 & 182,79 & 182,97 \\ \hline \pagebreak
\multirow{12}{*}{\begin{tabular}[c]{@{}c@{}}Média\\ Limpa\\ {[}cm{]}\end{tabular}} & \multirow{4}{*}{30ms} & Est. & 194,84 & 189,40 & 192,26 & 182,45 & 182,72 \\
 &  & Din. & 200,18 & 189,56 & 211,24 & 182,13 & 182,67 \\
 &  & Est. & 194,72 & 189,42 & 206,54 & 182,01 & 182,48 \\
 &  & Din. & 191,33 & 189,25 & 202,63 & 182,43 & 182,72 \\ \cline{2-8} 
 & \multirow{4}{*}{45ms} & Est. & 196,53 & 189,63 & 220,25 & 182,33 & 182,75 \\
 &  & Din. & 197,32 & 189,51 & 208,81 & 182,87 & 183,20 \\
 &  & Est. & 193,73 & 189,55 & 209,55 & 182,76 & 183,12 \\
 &  & Din. & 198,06 & 188,22 & 192,27 & 182,97 & 183,50 \\ \cline{2-8} 
 & \multirow{4}{*}{60ms} & Est. & 191,09 & 189,49 & 189,49 & 182,46 & 183,18 \\
 &  & Din. & 191,65 & 189,61 & 212,97 & 182,71 & 183,24 \\
 &  & Est. & 190,08 & 189,77 & 196,97 & 182,60 & 182,85 \\
 &  & Din. & 189,75 & 188,77 & 192,45 & 182,79 & 182,97 \\ \hline
\multirow{12}{*}{\begin{tabular}[c]{@{}c@{}}Desvio\\ Padrão\\ {[}cm{]}\end{tabular}} & \multirow{4}{*}{30ms} & Est. & 25,47 & 0,51 & 16,06 & 0,56 & 0,72 \\
 &  & Din. & 43,75 & 0,50 & 42,00 & 0,65 & 0,71 \\
 &  & Est. & 64,48 & 0,51 & 32,18 & 0,74 & 0,66 \\
 &  & Din. & 5,85 & 0,43 & 28,28 & 0,82 & 0,77 \\ \cline{2-8} 
 & \multirow{4}{*}{45ms} & Est. & 10,08 & 0,49 & 39,51 & 0,48 & 0,69 \\
 &  & Din. & 82,97 & 0,53 & 34,85 & 0,75 & 0,93 \\
 &  & Est. & 41,49 & 0,53 & 33,54 & 0,65 & 0,90 \\
 &  & Din. & 84,75 & 9,48 & 14,72 & 0,79 & 1,24 \\ \cline{2-8} 
 & \multirow{4}{*}{60ms} & Est. & 41,69 & 0,53 & 6,76 & 0,54 & 24,97 \\
 &  & Din. & 33,94 & 0,50 & 35,49 & 0,64 & 1,14 \\
 &  & Est. & 88,21 & 0,42 & 22,80 & 0,67 & 0,83 \\
 &  & Din. & 41,38 & 7,62 & 13,07 & 0,70 & 0,90 \\ \hline
\multirow{12}{*}{\textless avg - 15} & \multirow{4}{*}{30ms} & Est. & 0,00\% & 0,00\% & 0,00\% & 0,00\% & 0,00\% \\
 &  & Din. & 0,00\% & 0,00\% & 71,33\% & 0,00\% & 0,00\% \\
 &  & Est. & 0,00\% & 0,00\% & 54,00\% & 0,00\% & 0,00\% \\
 &  & Din. & 0,00\% & 0,00\% & 1,33\% & 0,00\% & 0,00\% \\ \cline{2-8} 
 & \multirow{4}{*}{45ms} & Est. & 0,00\% & 0,00\% & 62,00\% & 0,00\% & 0,00\% \\
 &  & Din. & 0,00\% & 0,00\% & 73,33\% & 0,00\% & 0,00\% \\
 &  & Est. & 0,00\% & 0,00\% & 75,33\% & 0,00\% & 0,00\% \\
 &  & Din. & 0,00\% & 2,67\% & 0,00\% & 0,00\% & 0,00\% \\ \cline{2-8} 
 & \multirow{4}{*}{60ms} & Est. & 0,00\% & 0,00\% & 0,00\% & 0,00\% & 0,00\% \\
 &  & Din. & 0,00\% & 0,00\% & 72,00\% & 0,00\% & 0,00\% \\
 &  & Est. & 0,00\% & 0,00\% & 0,00\% & 0,00\% & 0,00\% \\
 &  & Din. & 0,00\% & 2,00\% & 0,00\% & 0,00\% & 0,00\% \\ \hline
\multirow{12}{*}{\textgreater avg + 15} & \multirow{4}{*}{30ms} & Est. & 18,67\% & 0,00\% & 4,00\% & 0,00\% & 0,00\% \\
 &  & Din. & 0,67\% & 0,00\% & 26,67\% & 0,00\% & 0,00\% \\
 &  & Est. & 16,00\% & 0,00\% & 20,00\% & 0,00\% & 0,00\% \\
 &  & Din. & 4,67\% & 0,00\% & 14,67\% & 0,00\% & 0,00\% \\ \cline{2-8} 
 & \multirow{4}{*}{45ms} & Est. & 25,33\% & 0,00\% & 38,00\% & 0,00\% & 0,00\% \\
 &  & Din. & 11,33\% & 0,00\% & 24,00\% & 0,00\% & 0,00\% \\
 &  & Est. & 10,00\% & 0,00\% & 22,67\% & 0,00\% & 0,00\% \\
 &  & Din. & 15,33\% & 0,00\% & 3,33\% & 0,00\% & 0,00\% \\ \cline{2-8} 
 & \multirow{4}{*}{60ms} & Est. & 6,00\% & 0,00\% & 0,67\% & 0,00\% & 0,00\% \\
 &  & Din. & 2,67\% & 0,00\% & 27,33\% & 0,00\% & 0,00\% \\
 &  & Est. & 0,00\% & 0,00\% & 8,67\% & 0,00\% & 0,00\% \\
 &  & Din. & 0,00\% & 0,00\% & 2,67\% & 0,00\% & 0,00\% \\ \hline
\multirow{12}{*}{= 400} & \multirow{4}{*}{30ms} & Est. & 1,33\% & 0,00\% & 0,00\% & 0,00\% & 0,00\% \\
 &  & Din. & 4,67\% & 0,00\% & 1,33\% & 0,00\% & 0,00\% \\
 &  & Est. & 10,67\% & 0,00\% & 0,00\% & 0,00\% & 0,00\% \\
 &  & Din. & 0,00\% & 0,00\% & 0,00\% & 0,00\% & 0,00\% \\ \cline{2-8} 
 & \multirow{4}{*}{45ms} & Est. & 0,00\% & 0,00\% & 0,00\% & 0,00\% & 0,00\% \\
 &  & Din. & 20,67\% & 0,00\% & 0,00\% & 0,00\% & 0,00\% \\
 &  & Est. & 4,00\% & 0,00\% & 0,00\% & 0,00\% & 0,00\% \\
 &  & Din. & 22,00\% & 0,00\% & 0,00\% & 0,00\% & 0,00\% \\ \cline{2-8} 
 & \multirow{4}{*}{60ms} & Est. & 4,00\% & 0,00\% & 0,00\% & 0,00\% & 1,33\% \\
 &  & Din. & 2,67\% & 0,00\% & 0,00\% & 0,00\% & 0,00\% \\
 &  & Est. & 22,67\% & 0,00\% & 0,00\% & 0,00\% & 0,00\% \\
 &  & Din. & 4,00\% & 0,00\% & 0,00\% & 0,00\% & 0,00\% \\ \hline
\end{longtable}
\end{center}
