JoaoVictorGordo/high-speed-robot/monografia/LaTeX/Template/folhadeaprovacao.pdf

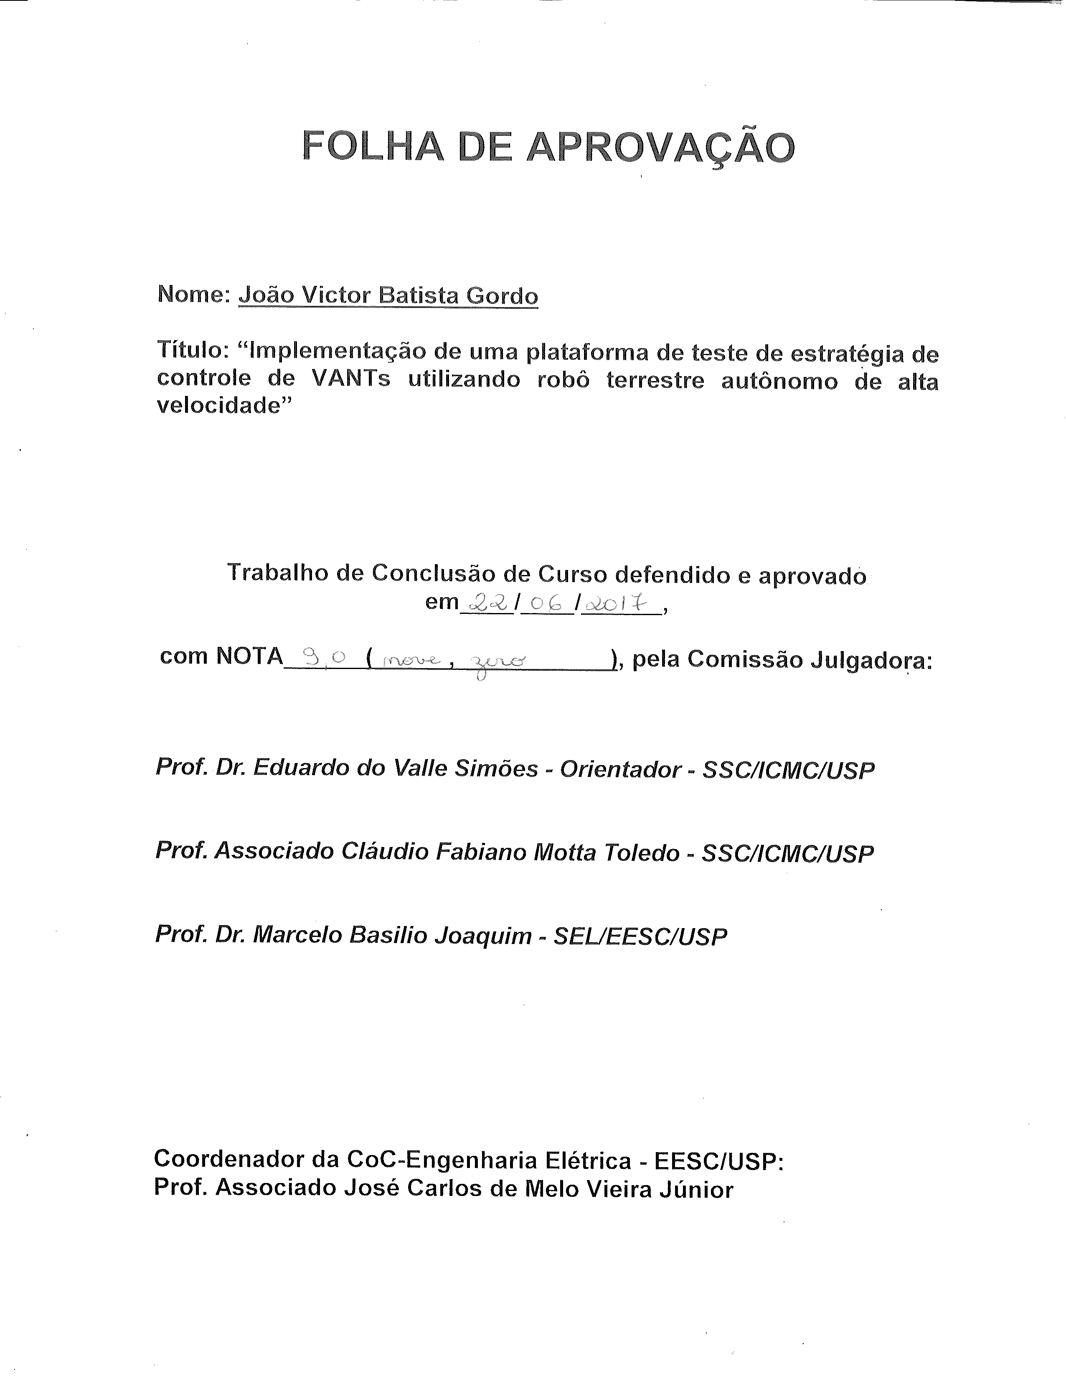
[picture p7: page 1]
