JoaoVictorGordo/high-speed-robot/monografia/LaTeX/Template/USPSC-EstruturaTrabAcad.pdf

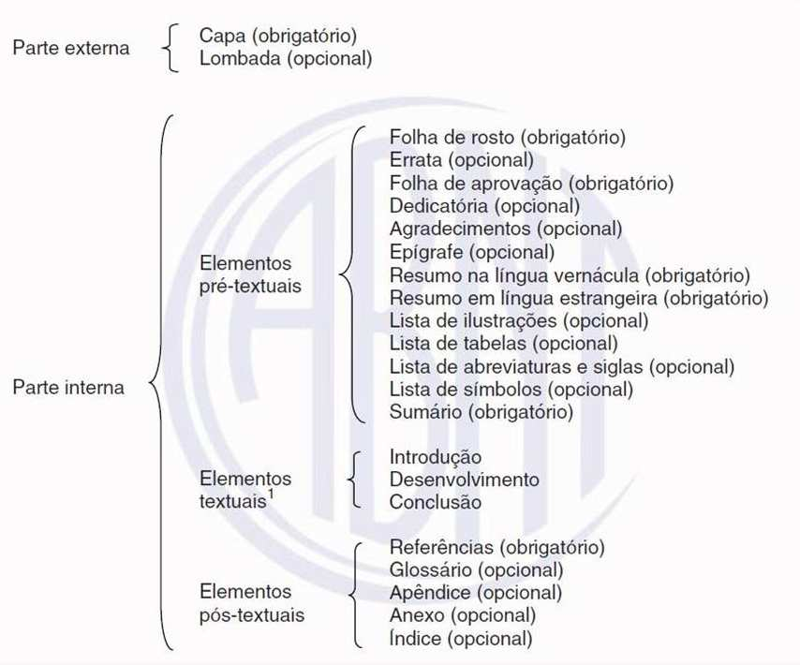
[picture p8: figure]
