JoaoVictorGordo/high-speed-robot/monografia/Imagens/BLDC.JPG

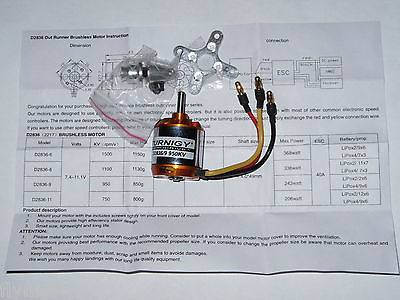
monografia/Imagens/BLDC.JPG
