JoaoVictorGordo/high-speed-robot/monografia/Imagens/ESC.jpg

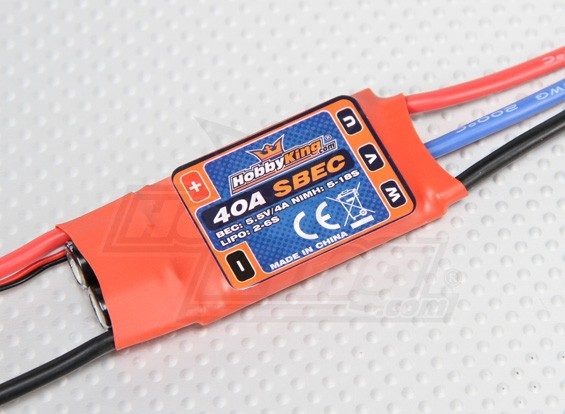
monografia/Imagens/ESC.jpg
