JoaoVictorGordo/high-speed-robot/monografia/testes/interf_motor_sonar.ods

Sheet: Sheet1
400 | 63 | 400 | 400 | 400 | STP | 104 | 90 | a
400 | 400 | 400 | 400 | 400 | STP | 104 | 90 | b | Media | 399,4922879177 | 261,4492287918 | 400 | 400 | 400
400 | 400 | 400 | 400 | 400 | STP | 104 | 90 | c | Desvio Padrão | 12,6690918043 | 138,2188831247 | 0 | 0 | 0
400 | 400 | 400 | 400 | 400 | STP | 104 | 90 | d | Contagem | 0,0016066838 | 0,5041773779 | 0 | 0 | 0
400 | 400 | 400 | 400 | 400 | STP | 104 | 90 | e
400 | 73 | 400 | 400 | 400 | STP | 104 | 90 | f | STP | 398,6465517241 | 338,8548850575 | 400 | 400 | 400
400 | 400 | 400 | 400 | 400 | STP | 104 | 90 | g | E_L | 399,078313253 | 235,9036144578 | 400 | 400 | 400
400 | 63 | 400 | 400 | 400 | STP | 104 | 90 | h | E_M | 400 | 218,7525083612 | 400 | 400 | 400
400 | 400 | 400 | 400 | 400 | STP | 104 | 90 | i | E_F | 400 | 233,4882154882 | 400 | 400 | 400
400 | 400 | 400 | 400 | 400 | STP | 104 | 90 | j | D_L | 398,8859060403 | 315,8020134228 | 400 | 400 | 400
400 | 400 | 400 | 400 | 400 | STP | 104 | 90 | k | D_M | 400 | 216,7986577181 | 400 | 400 | 400
400 | 68 | 400 | 400 | 400 | STP | 104 | 90 | l | D_F | 400 | 246,8552188552 | 400 | 400 | 400
400 | 400 | 400 | 400 | 400 | STP | 104 | 90 | m
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
