JoaoVictorGordo/high-speed-robot/monografia/testes/teste_intervalo.ods

Sheet: 30cm_quina
0 | 30 | 0 | 400 |  |  | Sensor 0 | Sensor 1 | Sensor 2 | Sensor 3 | Sensor 4 | leitura
26 | 30 | 31 | 36 | 38 | Média | 26,43 | 30,13 | 31,14 | 35,62 | 37,19 | estática
27 | 31 | 33 | 36 | 37 |  | 26,58 | 30,57 | 30,55 | 35,67 | 37,51 | dinâmica
26 | 30 | 30 | 36 | 37 |  | 26,37 | 30,12 | 30,99 | 35,66 | 37,21 | estática
26 | 30 | 37 | 35 | 37 |  | 26,42 | 30,60 | 32,17 | 35,61 | 37,52 | dinâmica
26 | 30 | 37 | 35 | 37 |  | 26,36 | 30,51 | 32,61 | 35,67 | 37,34 | estática
27 | 31 | 33 | 36 | 37 |  | 26,39 | 30,86 | 32,31 | 35,76 | 37,73 | dinâmica
27 | 30 | 34 | 35 | 38 |  | 26,45 | 30,26 | 31,59 | 35,75 | 37,17 | estática
26 | 30 | 31 | 35 | 37 |  | 26,42 | 30,29 | 29,11 | 35,65 | 37,36 | dinâmica
26 | 30 | 31 | 35 | 38 |  | 26,41 | 30,12 | 31,28 | 35,67 | 37,21 | estática
27 | 31 | 33 | 36 | 37 |  | 26,72 | 30,48 | 31,11 | 35,71 | 37,65 | dinâmica
26 | 30 | 33 | 36 | 37 |  | 26,46 | 30,01 | 30,38 | 35,61 | 37,15 | estática
26 | 30 | 30 | 36 | 37 |  | 26,52 | 30,35 | 28,47 | 35,50 | 37,33 | dinâmica
27 | 31 | 33 | 36 | 37
27 | 30 | 30 | 35 | 37 | Média Limpa | 26,43 | 30,13 | 31,14 | 35,62 | 37,19 | estática
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
