JoaoVictorGordo/high-speed-robot/monografia/testes/teste_interf_motor_sonar_raw.ods

Sheet: Sheet1
starting!!!
 | a | 400 | 63 | 400 | 400 | 400 | 104 | 90
 | b | 400 | 400 | 400 | 400 | 400 | 104 | 90
 | c | 400 | 400 | 400 | 400 | 400 | 104 | 90
 | d | 400 | 400 | 400 | 400 | 400 | 104 | 90
 | e | 400 | 400 | 400 | 400 | 400 | 104 | 90
 | f | 400 | 73 | 400 | 400 | 400 | 104 | 90
 | g | 400 | 400 | 400 | 400 | 400 | 104 | 90
 | h | 400 | 63 | 400 | 400 | 400 | 104 | 90
 | i | 400 | 400 | 400 | 400 | 400 | 104 | 90
 | j | 400 | 400 | 400 | 400 | 400 | 104 | 90
 | k | 400 | 400 | 400 | 400 | 400 | 104 | 90
 | l | 400 | 68 | 400 | 400 | 400 | 104 | 90
 | m | 400 | 400 | 400 | 400 | 400 | 104 | 90
 | n | 400 | 400 | 400 | 400 | 400 | 104 | 90
 | o | 400 | 400 | 400 | 400 | 400 | 104 | 90
 | p | 400 | 400 | 400 | 400 | 400 | 104 | 90
 | q | 400 | 141 | 400 | 400 | 400 | 104 | 90
 | r | 400 | 400 | 400 | 400 | 400 | 104 | 90
 | s | 400 | 400 | 400 | 400 | 400 | 104 | 90
 | t | 400 | 104 | 400 | 400 | 400 | 104 | 90
 | u | 400 | 400 | 400 | 400 | 400 | 104 | 90
 | v | 400 | 400 | 400 | 400 | 400 | 104 | 90
 | w | 400 | 400 | 400 | 400 | 400 | 104 | 90
 | x | 400 | 400 | 400 | 400 | 400 | 104 | 90
 | y | 400 | 400 | 400 | 400 | 400 | 104 | 90
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
