JoaoVictorGordo/high-speed-robot/monografia/testes/resultado_final.ods

 |  |  |  | Legenda | Legenda
 |  |  |  | OR | OR | EF |  | DF | DF | STP | Fr | USS
 |  |  |  | Out of Range | Out of Range | Esquerda Forte |  | Direita Forte | Direita Forte | Stop | Frente | Ultrasonic Sensor | Ultrasonic Sensor
TESTE 1: BATEU - VÍDEO DA PIRUETA - |  |  |  |  |  |  | TESTE 2: DESVIOU |  |  |  |  |  |  | TESTE 3: DESVIOU
USS4 | USS3 | USS2 | USS1 | USS0 | Manobra |  | USS4 | USS3 | USS2 | USS1 | USS0 | Manobra |  | USS4 | USS3 | USS2 | USS1 | USS0 | Manobra
400 | 400 | 400 | 400 | 400 | OR |  | 400 | 400 | 400 | 400 | 400 | OR |  | 400 | 306 | 400 | 220 | 400 | OR
400 | 400 | 400 | 400 | 400 | OR |  | 400 | 400 | 400 | 400 | 400 | OR |  | 400 | 400 | 400 | 298 | 400 | OR
400 | 400 | 400 | 324 | 400 | OR |  | 400 | 400 | 400 | 319 | 400 | OR |  | 400 | 400 | 400 | 400 | 400 | OR
400 | 400 | 400 | 400 | 400 | OR |  | 400 | 316 | 400 | 242 | 400 | OR |  | 400 | 307 | 400 | 400 | 400 | OR
400 | 307 | 400 | 400 | 400 | OR |  | 400 | 230 | 400 | 159 | 400 | OR |  | 400 | 214 | 400 | 400 | 400 | OR
400 | 211 | 400 | 400 | 400 | OR |  | 365 | 230 | 400 | 141 | 400 | OR |  | 400 | 119 | 400 | 320 | 400 | OR
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
