JoaoVictorGordo/high-speed-robot/(commit log)

2017-05-08 simplified code and stuff, added files to .gitignore
    [interferencia_motor_sonar.ods, leituras_espurias.ods, resultado_final.ods]
2017-05-20 added Tabelas dir with dyn/static tests
    [teste_interf_motor_sonar.ods]
2017-08-04 submited term paper
    [Pasta1.xlsx, interf_motor_sonar.ods, interferencia_motor_sonar.ods, leituras_espurias.ods, log.xlsx, log2.xlsx, res.xlsx, resultado_final.ods]
