JoaoVictorGordo/high-speed-robot/(notices)

Notices in the files:
monografia/LaTeX/Template/USPSC-modelo-seg.tex:
Copyright 2012-2015 by abnTeX2 group at https://www.abntex.net.br
